Vistoun/EMG-arm/README.md

# EMG-arm
3D vytisknuta roboticka ruka v realné velikosti, poháněna servy. Ovladana pomocí EMG senzorů. 

## Cíl
  **Zkonstuovaní robotické ruky ovládané pomocí EMG (svalových) senzorů.**

## Hardware 
- InMoov robotic arm 
- MyoWare Muscle Sensor
- Arduino UNO R3
- I2C OLED display 128x64
- Rotační enkodér
- 6xMG995R Servo 
- Pololu Micro Maestro 6-CHANNEL
- LiPol 2s 25C battery 
- 5V voltage regulator

### What to do: 
- Složení ruky
- Naprogramování pohybů 
- Naprogramování EMG senzorů 
- Dokumentace 

## Harmonogram

### Červenec 
- ~~Analýza EMG senzorů~~
- ~~Výběr EMG senzorů~~
- ~~Kalibrace EMG senzorů~~ 

### Srpen 
- ~~Výběr modelu ruky~~
- ~~Tisk ruky~~

### Září 
- ~~Složení ruky~~ 

### Říjen 
- ~~Programování ruky~~
- ~~Programování ovládaní pomoci displeje a enkodéru~~ 

### Listopad 
- ~~Programování senzorů~~
- ~~Dokončování pogramovaní~~
- ~~Optimalizace~~
- ~~Přidělání a modelování hardwareové části ruky~~

### Prosinec 
- ~~Dokumentace~~
- ~~Prezentace~~
- ~~Schemata~~
- ~~Posledni dodělávky~~

## Zdroje
 - [Konkureční projekt](https://static1.squarespace.com/static/5fdf30e82dcd53187f20b7f4/t/5fe09c7ef5f64226567c5b9e/1608555676841/Low+Cost+Prosthetic+Arm+Thesis.pdf)
 - [Deníček](https://docs.google.com/document/d/1iRJr1iKNz3n8BKfak4A2ild2_8w_wcecvySByJWGgLg/edit#)
