Vistoun/EMG-arm/docs/lacheta-zaverecne-prace.pdf

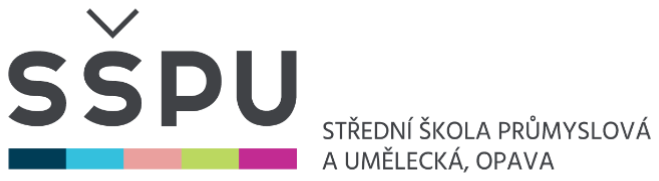
[picture p1: figure]

# ZÁVĚREČNÁ STUDIJNÍ PRÁCE

## dokumentace

# Robotická ruka s využitím EMG

# Václav Lacheta

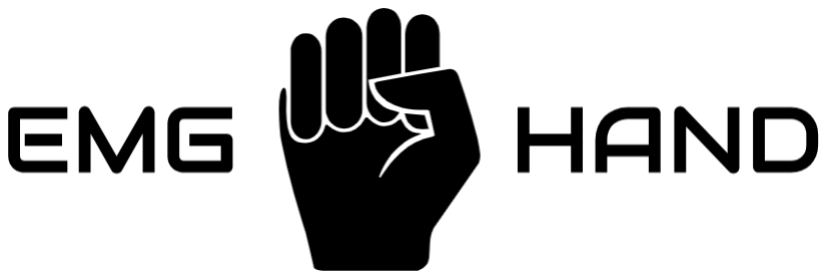
[picture p2: figure]

Obor: | 18-20-M/01 INFORMAČNÍ TECHNOLOGIE se zaměřením na počítačové sítě a programování
Třída: Školní rok: | IT4
| 2021/2022

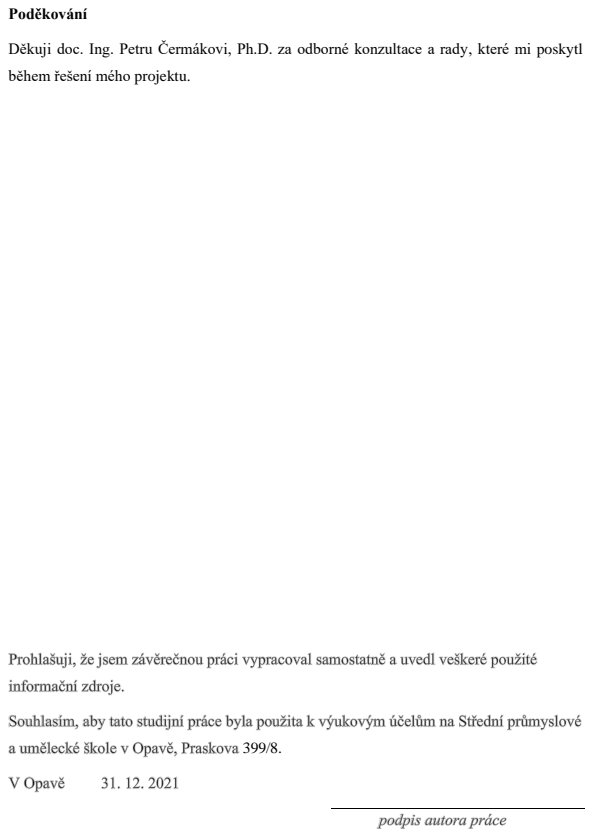
[picture p3: page 2]
Poděkování

Děkuji doc. Ing. Petru Čermákovi, Ph.D. za odborné konzultace a rady, které mi poskytl

během řešení mého projektu.

ANOTACE

Součástí práce bylo sestavení protetické ruky inMoov v životní velikosti ze součástek vy-

tisknutých na 3D tiskárně. Umělá ruka je ovládána pomoci elektromyografických (EMG)

senzorů, díky nimž je možné získávat elektrické svalové signály a převádět je na mechanické

pohyby napodobující chování skutečné lidské ruky. Ruka je upevněna na podstavci obsahu-

jícím nezbytný hardware včetně displeje a rotačního enkoderu, který lze použít k ovládání.

Zařízení je možné ovládat manuálně (natočit každý prst do libovolného úhlu), pomocí EMG

senzorů nebo zvolit některé z naprogramovaných gest.

Klíčová slova

EMG, elektromyografie, InMoov, myoelektrická protéza, rotační enkodér, servomotor, Ar-

duino, 3D tisk, displej

OBSAH

### 3 MOŽNÉ ZPŮSOBY ZPRACOVÁNÍ EMG SIGNÁLU A JEJICH

Závěrečná studijní práce, Václav Lacheta, IT4, 2021/2022

5

ÚVOD

Nad výběrem závěrečné práce jsem přemýšlel dlouhou dobu. Hledal jsem takový projekt,

při jehož řešení bych mohl uplatnit své znalosti programování mikrokontrolerů a využít i

rozmanitou zásobu elektronických součástek, které jsem nashromáždil v průběhu svého stu-

dia na střední škole. Zároveň jsem si přál pustit se také do něčeho nového, co by představo-

valo zajímavou výzvu pro mě samotného a případně bylo přínosné i pro druhé.

Jednoho dne jsem zhlédl video s ukázkou robotické ruky, která se ovládá pomocí EMG sen-

zorů. V tu chvíli jsem se rozhodl, že právě to bude téma mého závěrečného projektu. Navíc

jsem vždy tento typ protézy považoval za něco, co si nemůže normální smrtelník sestavit

doma, takže jsem byl i hodně zvědavý, zda se mi to povede.

Nyní tedy předkládám výsledek své práce, která trvala několik měsíců. Podařilo se mi do-

sáhnout většiny dílčích cílů, které jsem si vytyčil. Z finančních důvodů jsem si bohužel ne-

mohl dovolit pořídit více EMG senzorů a musel jsem si vystačit pouze s jedním, pomocí

kterého dokáži monitorovat sevření nebo otevření pěsti a následně tento pohyb převést na

robotickou ruku.

V praxi se s mým řešením moc nesetkáme, tento způsob se spíše využívá ve světě medicíny

a bioinformatiky pro diagnostiku. Vyspělejší protézy se spíše zaměřují na umístění elektrod

uvnitř svalu, jelikož jsou získávány mnohem přesnější signály.

V úvodní kapitole své dokumentace se zabývám vývojem protéz v historii a popisuji některá

zajímavá technická řešení, která se objevila v minulosti i ta, která se používají dnes. Další

část je zaměřena na problematiku elektromyografie, jež studuje strukturu kosterní svaloviny

a elektrické biosignály, které ze svalů vycházejí. Díky poznatkům tohoto oboru můžeme

využívat EMG senzory a snímat pomocí nich impulzy lidského těla. Nejdůležitější část mé

práce je podrobněji věnována technickému a programovému řešení projektu InMoov ruky.

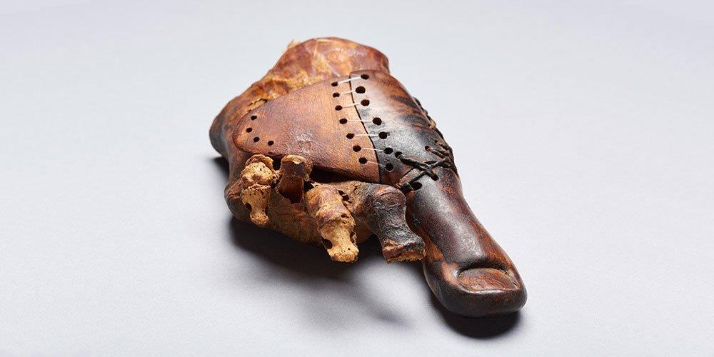
[picture p4: figure]

6

### 1 PROTÉZY

Protézu lze definovat jako „umělé zařízení, které nahrazuje nebo doplňuje chybějící či naru-

šenou část lidského těla“.

V dnešní době existuje mnoho různých typů protéz. Ty se pohybují od kosmetických ozdob

přes jednoduché pasivní mechanické pomůcky, jako jsou různé háky a podobně, až po elek-

tricky poháněné protézy, které mohou alespoň částečně obnovit funkci chybějící končetiny.

### 1.1 Historie protéz

Myšlenka umělého nahrazení ztracených končetin existuje již tisíce let. Existují protézy,

které jsou více než 3000 let staré. Příkladem je takzvaný „káhirský prst“, který byl nalezen

u egyptské mumie a měl nahradit ztracený palec u nohy. Protézy, jako je tato, byly kdysi

vyráběny pomocí přírodních surovin: kůže, dřeva či lnu.

Obrázek 1: Káhirský prst

V roce 300 před naším letopočtem byla Římany vyrobena první známá protetická noha, tak-

zvaná „noha Capua“. Byla vyrobena ze železa a bronzu a měla dřevěné jádro. Během této

doby se objevily protézy, jako jsou ruční háky a kolíkové nohy, které umožnovaly chůzi

nebo držení štítů. Ty byly sestrojeny převážně ze železa a oceli.

7

V době renesance udělala anestezie a léčba ran veliký pokrok, amputace proto byly bez-

pečnější než kdy dříve. S novými možnostmi amputace se začaly šířit vynálezy, jakým byl

například tzv. turniket, které pomohly zastavit těžké krvácení v průběhu amputace. Vznikaly

nové typy protéz - například „železná ruka rytíře Götz von Berlichingen“, s níž bylo možné

pohybovat a manipulovat pomocí pružinového mechanismu uvnitř ruky. V této době se na

protézy používalo především železo, ocel, měď a dřevo.

V období americké občanské války, ale i během světových válek zažila protetika velký po-

sun vpřed vyplývající z vysokého počtu zmrzačených vojáků. Kromě toho byl vyvinut i zcela

nový materiál - pryž, který doplňoval dřívější protézy ze dřeva a kůže.

V letech po druhé světové válce bylo objeveno mnoho dalších materiálů, díky kterým se

dřevo a kůže staly nepotřebnými. Patří mezi ně pryskyřice, polykarbonát, plast a lamináty.

Díky jejich použití se protézy staly lehčí a odolnější.

Materiálové složení se v posledních letech dále zdokonaluje a v současnosti vznikají vysoce

výkonné protézy, které mají vyšší stabilitu, pohodlí a nižší hmotnost. Kromě toho mohou

být součástí protéz senzory umožňující aktivní ovládaní pomocí mikroprocesorů. Vývoj mo-

derních protéz se může opřít i o nové výrobní procesy, jako je 3D tisk, který umožňuje vy-

robit velmi jednoduché i levné protézy.

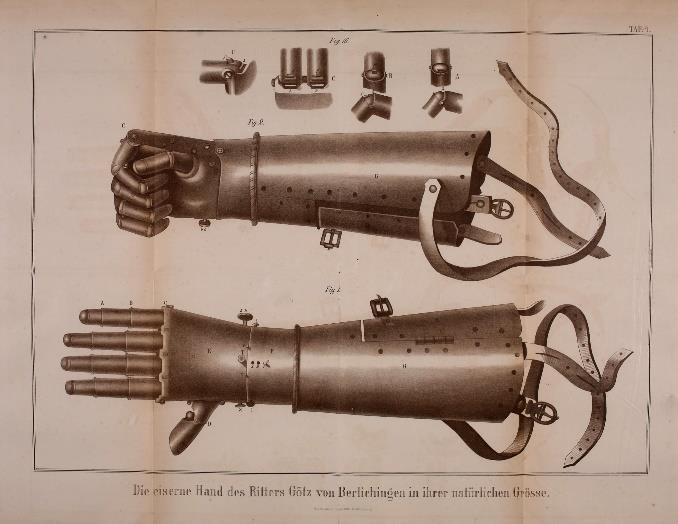
[picture p5: figure]
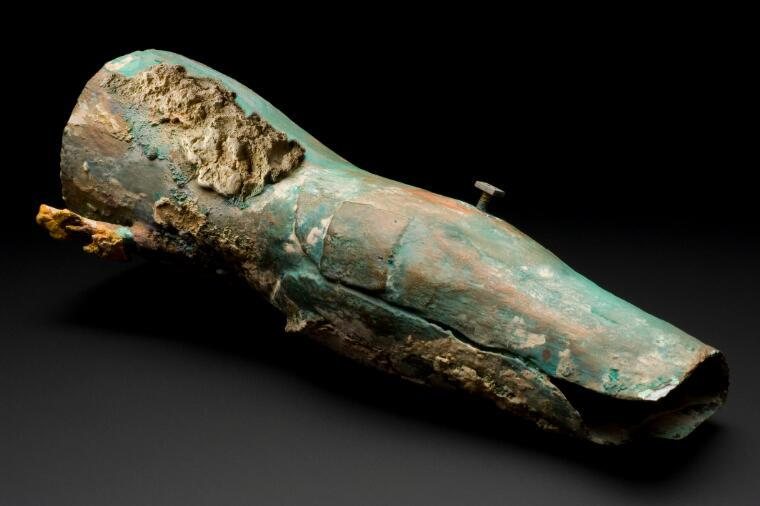
[picture p6: figure]

Obrázek 1.2: Noha Capua | Obrázek 1.3: Ruka Götz von Berlichingen

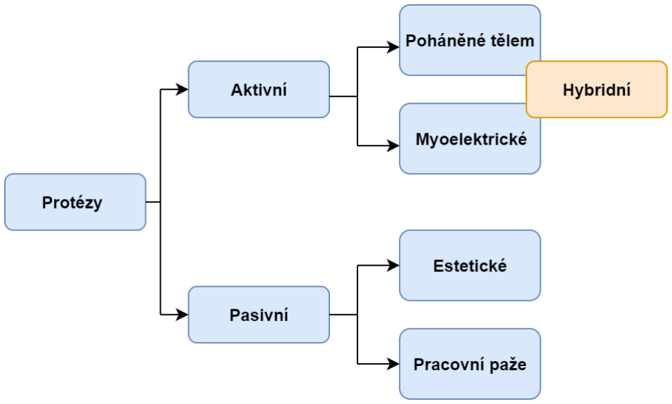
[picture p7: figure]

8

### 1.2 Klasifikace protéz

Protézy můžeme rozdělit na:

1. Pasivní. Protézy, které nemají žádné pohyblivé části. Ty se většinou používají pro

estetické účely. Existují také protézy určené pro speciální úkoly, jako je zahradničení

nebo sport.

2. Aktivní. Ty jsou naopak určeny k podpoře vyšší produktivity a funkčnosti. Mají po-

hyblivé části, které jsou poháněny buď samotným tělem, nebo vnější energií. Navíc

existují ještě hybridní kombinace, které jsou poháněny částečně tělem a částečně

akčními členy

Toto rozdělní je znázorněno na obrázku 1.4.

Obrázek 1.4: Rozdělení protéz

Protézy mohou plnit dva různé úkoly, které se mohou zásadně lišit. Na jednu stranu, protézy

mají obnovit funkce, které byly ztraceny ztrátou končetiny a na druhou stranu se protézy

používají k optické obnově „normálního stavu“ těla. Protézy, které vizuálně připomínají

chybějící končetinu, mají často omezenou funkčnost, zatímco funkční protézy nejsou moc

dobré po vizuální stránce. Proto existuje mnoho pacientů, kteří mají několik různých protéz,

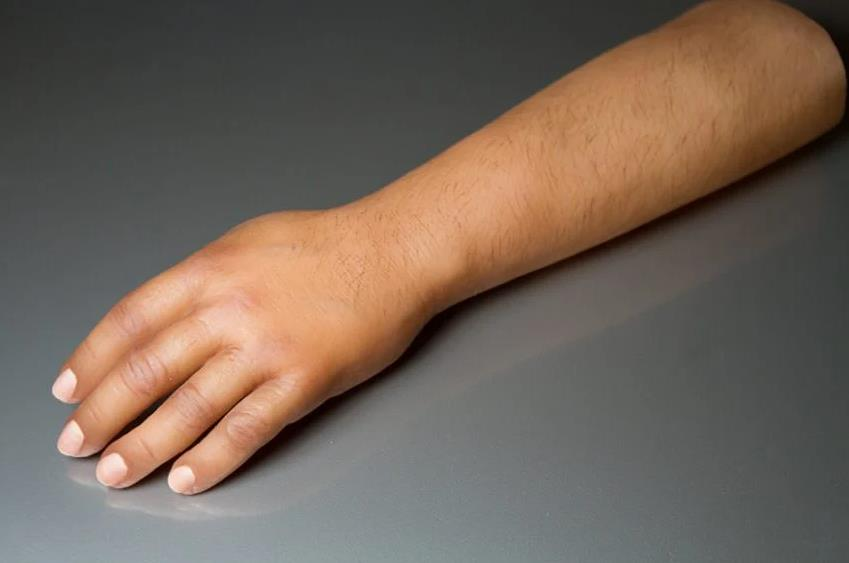
[picture p8: figure]

9

například jednu, která vizuálně připomíná chybějící končetinu, a druhou, která je maximálně

funkční.

### 1.3 Pasivní protézy

Kosmetické použití protéz je velmi důležité, protože zejména horní končetiny jsou často

používané v sociálních interakcích, jako jsou gesta nebo během komunikace. Vizuálně ne-

nápadný vzhled tak může pomoci vyhnout se psychickému stresu z důvodu odlišnosti od

ostatních. To platí zejména v případě, kdy amputací není postiženo pouze předloktí, ale i

paže. Nejlepší reprezentace přirozené ruky poskytují pasivní kosmetické protézy. Lze je při-

způsobit pacientovi pomocí tvaru a barvy; například napodobit barvu kůže a anatomické

rysy, jako jsou znaménka, nebo dokonce ochlupení na pažích. Estetické protézy lze také

použít pro jednoduché manuální úkoly, jako je fixace papíru při psaní. Obecně jsou velmi

lehké a mají vysoký komfort nošení.

### 1.4 Aktivní protézy

Nejčastěji se vyskytují protézy aktivní. Tyto mají pohyblivé částí, které jsou poháněny buď

tělem, nebo vlastním zdrojem energie. S tělesně poháněnými protézami se ovládání provádí

pohybem svalu v blízkosti amputované končetiny. U myoelektrických proté, jsou akční po-

tenciály svalu monitorovány senzory a použity pro pohyb protézy. Aktivní protézy mohou

mít mnoho podob, jako například ruce, pohyblivé háky nebo speciální tvary pro konkrétní

pacienty. Tento druh protéz je obvykle těžší než pasivní, jelikož jsou pro ně určeny větší

Obrázek 1.5: Příklad pasivní protézy

10

zátěže. Díky tomu jsou často vyrobeny z těžších, ale odolnějších materiálů, jako jsou kov nebo tvrzený plast. Úkolem aktivních protéz je obnovit funkčnost postižených končetin, a

zejména ruka má velký význam pro manipulaci s objekty. Pomocí takových protéz je možné

uchopovat předměty a zvládat činnosti v každodenním životě.

### 1.4.1 Protézy poháněné tělem

Protézy poháněné tělem jsou často označovány jako „ovládané kabelem“, protože vyžadují

ocelové kabely během provozu. Obvykle jsou tyto postroje konstruovány tak, že popruh

prochází přes lopatku a připojuje se k tažnému lanku, které ovládá protézu. Protože protézy

poháněné tělem jsou přímo spojeny například s pohybem ramena, mají tak vysokou úroveň

zpětné vazby na základě napětí na ovládacím kabelu. Dalšími výhodami těchto protéz je, že

jsou ve většině případů vodotěsné a snadno se čistí. Jejich jednoduchý design umožnuje po-

stiženým osobám se je rychleji naučit ovládat, a navíc stojí výrazně méně ve srovnání s ak-

tivně řízenými.

Nevýhodou těchto protéz je, že k ovládání potřebují postroj k ovládání. To znamená, že po-

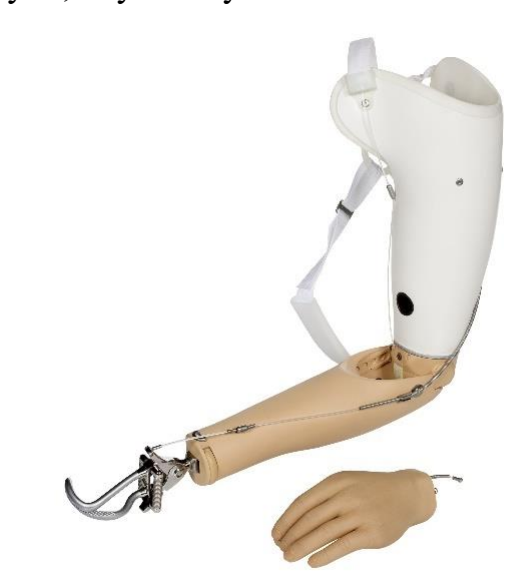
[picture p9: figure]

stižené osoby musí mít určitou sílu a svobodu pohybu, aby mohly takové zařízení ovládat.

Navíc jsou tyto protézy často vizuálně méně při-

tažlivé ve srovnání s elektricky poháněné, a to

kvůli postroji.

Protézy s takovým mechanickým přenosem síly

jsou oblíbenější než ty elektrické. Devadesát pro-

cent lidí, kteří mají aktivní protézu, používají pro-

tézu poháněnou tělem. Jejich největšími klady

jsou nízká hmotnost, odolná konstrukce a lepší

haptická odezva generovaná kabely.

### 1.4.2 Myoelektrické protézy

Tyto protézy jsou převážně elektrické. Mají externí zásobník energie, který napájí vestavěné

akční členy. Obecně se energie ukládá ve formě akumulátoru. Tato zařízení lze ovládat více

vstupy, jako jsou elektromyografické (EMG) signály, zpětná vazba motorů a také vyhrazené

spínače. Takové fyzické spínače jsou zvláště užitečné u vážných amputací. Je to proto, že

Obrázek 1.6: Příklad protézy poháněné

tělem

11

v takových případech obvykle existuje mnoho různých motorů, jsou zapotřebí různé spoje a

je třeba je ovládat samostatně.

Nicméně myoelektrické protézy se ještě častěji používají u méně vážných amputací. Myo-

elektrické protézy jsou založeny na měření elektrického vzruchu ve svalech. Elektrody při-

pojené ke svalům měří elektrické signály z kontrakcí kosterního svalstva. Změny elektro-

magnetických polí, které vznikají při napnutí svalu, zachycuje povrch elektrody a jsou v

podobě napěťových signálů posílány do mikrokontroleru.

Ve většině případů jsou elektrody připevněny ke dvěma svalům, které vykonávají pohyb

v určitém směru, jako je extenzor zápěstí a flexor zápěstí. Pro tento účel se používá jeden

sval pro jeden směr pohybu protézy. Například napnutím jednoho svalu se otevře dlaň a

napnutí protikusu se dlaň uzavře. Aby se zabránilo nedobrovolným pohybům, jsou pro sig-

nály EMG nastaveny prahové hodnoty. Teprve po překročení určitého prahu se protéza za-

čne pohybovat.

Jednou z výhod takové myoelektrické protézy je, že umožňuje větší uchopovací síly ve srov-

nání s protézami poháněnými tělem. V některých případech to může být výhodné při držení

objektů na delší dobu. Kromě toho nejsou pro účely ovládání potřeba žádné postroje. To

dovoluje ovládání více os a kloubů současně. Absence postroje také umožňuje, aby vypadaly

více jako skutečné končetiny.

Existují však také důvody, proč jsou protézy poháněné tělem 10krát populárnější než myo-

elektrické. Je to dáno především vyšší pořizovací cenou takových zařízení. Navíc jsou méně

robustní a kvůli vestavěné elektronice jen částečně vodotěsné. Protože mezi nimi není žádné

mechanické spojení zbývající končetiny s protézou, je haptická zpětná vazba horší. Někdy

je pro postižené těžší, aby správně vyhodnotili a použili požadovanou uchopovací sílu.

Kromě toho se tyto protézy kvůli složité konstrukci snadněji lámou a musí být častěji servi-

sovány.

Elektrody jsou jejich další nevýhodou, neboť se může stát, že se pohnou nebo ztratí kontakt.

V těchto případech nelze protézy správně provozovat. Konstantní kontakt s elektrodami

může také způsobit podráždění kůže nebo nepříjemný pocit, pokud protéza není správně

upravená. Přesto se tyto protézy neustále vyvíjejí a mohly by být v budoucnu více rozšířené.

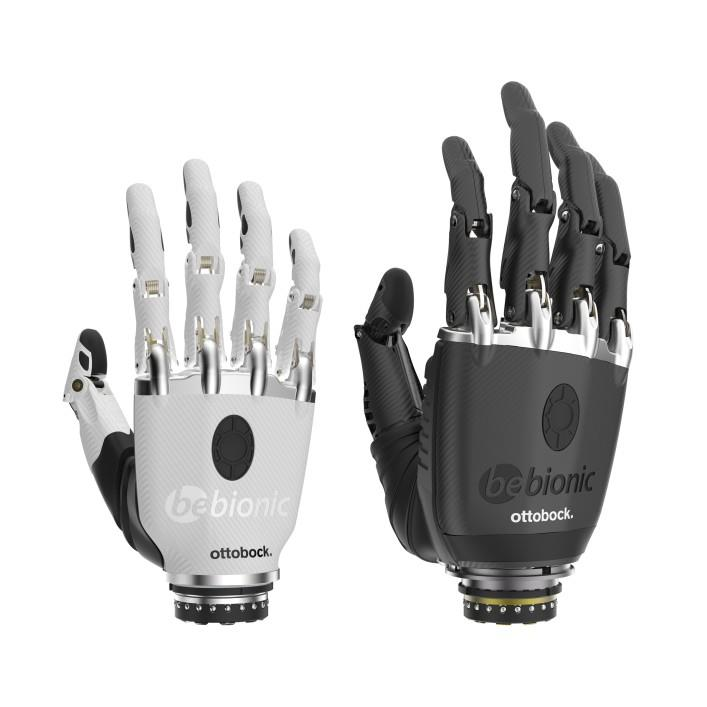
[picture p10: figure]

12

1.4.3Hybridní protézy

Existují i protézy, které se skládají z kombinace tělesně poháněných a myoelektrických. Tato

kombinace umožňuje využít výhody obou typů, například mohou dosáhnout vysokých ucho-

povacích sil při zachování nízké hmotnosti protézy. Navíc tento přístup může usnadnit ovlá-

dání protézy.

Obrázek 1.7: Myoelektrická protéza

13

### 2 ELEKTROMYOGRAFIE

### 2.1 Svaly horní končetiny

Kosterní svaly jsou součástí svalstva odpovědné za aktivní pohyby těla, a tedy i součástí

jednoho ze tří hlavních typů svalů. Stejně jako srdeční svaly patří kosterní svaly do skupiny

příčně pruhovaných svalů a označují se také jako dobrovolné svaly. Až na pár výjimek, jsou tyto svaly napojeny na kost šlachami. Často existují v párech, přičemž první sval je primár-

ním hybatelem a druhy je jeho antagonistou. Například, biceps a triceps jsou taková dvojice

antagonistů. Když se jeden z nich stáhne, druhý se uvolní a umožní pohyb a naopak.

Kosterní svaly mají složitou strukturu. Skládají se z fasciklů, které jsou svazky prodlouže-

ných svalových vláken. Samotná svalová vlákna se skládají ze svazků myofibril. Samotné

myofibrily jsou tvořeny z myozinových a aktinových vláken. Tato dvě vlákna jsou nasklá-

daná v pravidelně se opakujících sestavách a jsou zodpovědná za samotnou kontrakci svalů

klouzáním proti sobě navzájem. Tato myozinová pole se nazývají sarkomery. Motorické

neurony, které řídí kontrakci, jsou spojeny ve snopci svalových vláken a společně se nazývají

motorická jednotka.

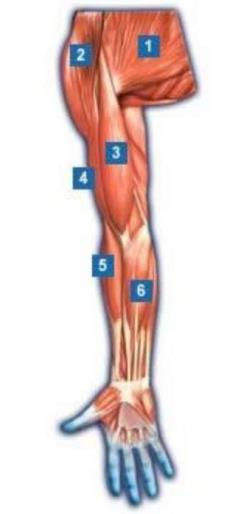
[picture p11: figure]

Nejdůležitější svaly jsou:

1. Musculus pectoralis major (velký sval prsní)
2. Musculus deltoideus (deltový sval)
3. Musculus bizeps brachii (dvojhlavý sval pažní)
4. Musculus trizeps brachii (trojhlavý sval pažní)
5. Musculus brachioradialis (sval vřetenní)
6. Musculus flexor digiti (sval který zajištuje ohýbaní prstů)

Motorické neurony se nacházejí uvnitř mozkového kmene a míchy a jsou spojeny se svalem

přes axony, který mohou přenášet excitační signál na velké vzdálenosti. Aktivace svalových

vláken se děje elektrickými potenciály buněčných membrán. Díky otevíráním a zavíráním

Obrázek 2.1: Svaly horní

končetiny

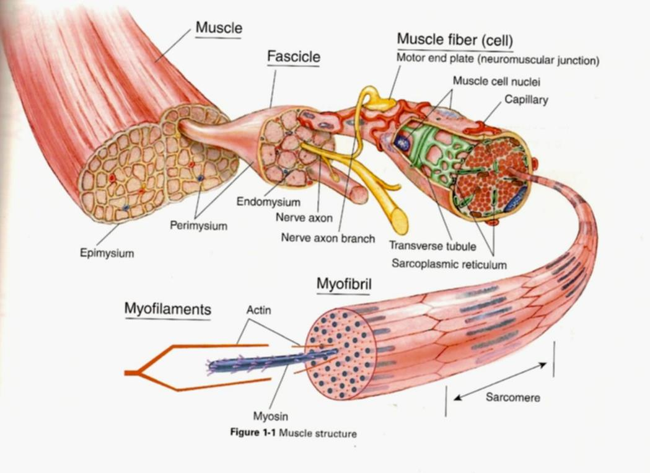
[picture p12: figure]

14

iontových kanálů umožnují membrány pohyb iontů a vytvořit tak signál elektromagnetic-

kého pole. Tento signál cestuje podél axonů jako vlna a skončí v motorickém neuronu.

Místo, kde se motorické neurony spojují se svalovými vlákny, se nazývá neuromuskulární

spojení. To je místo, kde vlákna začnou reagovat na signál motorického neuronu a tím za-

čnou kontrakce.

### 2.2 EMG signály

Akční potenciály se vytvářejí během kontrakce kosterní svaloviny. Tyto akční potenciály se

dají měřit a jsou také základem EMG signálů. EMG signály jsou používané pro analýzu a

klinickou diagnostiku v biomedicínských aplikacích, jako jsou rehabilitace pohybových vad.

Elektrické proudy generované během procesu flexe lze měřit pomocí elektrod na svalu nebo

uvnitř svalu. EMG signály jsou poměrně komplikované, protože jsou závislé na anatomii

fyziologické vlastnosti svalu. Nečistoty těchto signálů jsou zcela běžné a hromadí se při ces-

tování tělem. Signál EMG je také sumou několika motorických jednotek, které vysílají ve

stejnou dobu, a tak může docházet k interakcím mezi těmito různými signály.

Intervaly, ve kterých se vyskytují akční potenciály konkrétní motorické jednotky, jsou ná-

hodné.

Obrázek 2.2: Struktura kosterního svalu

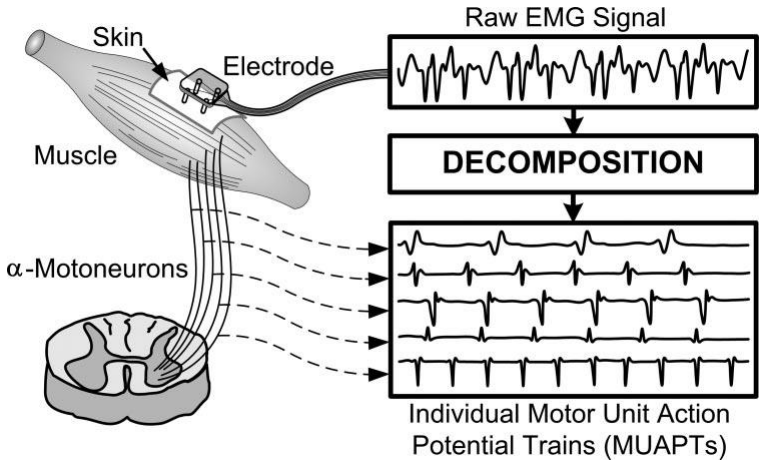
[picture p13: figure]

15

Samotný akční potenciál motorické jednotky je kombinací akčních potenciálů svalových

vláken patřící k jedné motorické jednotce. Lze to popsat vzorcem níže.

x(n) = ∑ ℎ(r)e(n − r) + w(n)

N−1

r=0

V tomto vzorci je x(n) výsledný EMG signál, e(n) impuls odpalu n, h(r) akční potenciál

motorické jednotky, w(n) aditivní bílý Gaussův šum a N počet střel motorických jednotek.

### 2.3 Snímání EMG signálů

EMG signály jsou snímány elektrodami, které jsou buď umístěny na kůži nad svalem, nebo

uvnitř svalu. Obě varianty mají svá pro a proti. Při použití intramuskulárních senzorů musí

být prostředí a senzory sterilizovány, protože se jedná o invazivní postup, který nese velké

riziko přenosu nemoci nebo spuštění infekce. Na druhou stranu, jakmile je elektroda umís-

těna, tak nezpůsobuje žádné nepohodlí a signály nejsou zkresleny tkáněmi svalů a kůže.

Tento proces vede k větší čistosti signálu nad šumem. Na druhou stranu, povrchové elek-

trody mohou být kdykoliv přemístěny, pokud poloha není vhodná a nepotřebuje k tomu

žádné invazivní postupy. Většinou se povrchové elektrody využívají pro krátká měření. Je

velmi důležité elektrody správně umístit a používat elektrody pro konkrétní úkol, výběr

Obrázek 2.3: Dekompozice EMG signálu

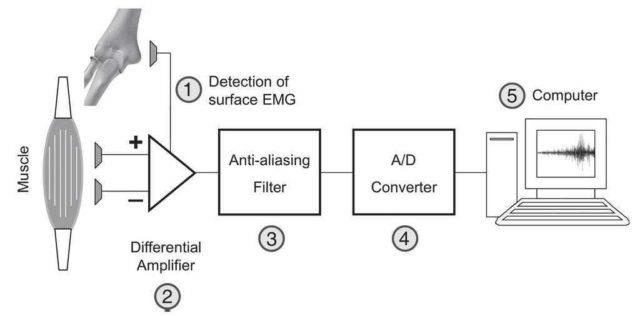
[picture p14: figure]

16

místa totiž velice ovlivní získaný signál. Chceme-li získat nejvyšší sílu signálu, tak elektrody

musí být umístěny uprostřed svalu ve směru svalových vláken. Nejčastější používané elek-

trody jsou Ag/AgCL, protože nejsou polarizovatelné a umožnují proudový tok kůže. Ve vět-

šině případů jsou připevněny pomocí vodivého gelu pro snížení impedanci kůže.

Obvykle se používají 2n + 1 elektrody. Dvě pro každý kanál n a jedna referenční (uzemňo-

vací) elektroda, která je umístěna na elektricky nesouvisející tkání.

Poté, co je signál zachycen, je obvykle zesílen, protože jeho amplituda je poměrně malá. Pro

první etapu zesílení se běžně používá diferenciální zesilovač. Diferenciální zesilovač se po-

užívá k eliminaci společných proudů. Signál je snímán na třech místech, dvě detekční elek-

trody a jedna referenční, která definuje neutrální zem, kterou sdílejí další dvě elektrody. Ja-

kýkoliv společný signál pro tyto dvě elektrody bude odstraněn, naopak signály, které nesdí-

lejí, budou poté zesíleny.

Poté se použije zesilovač k dalšímu zvýšení amplitudy signálu. Pro eliminaci vysokého šumu

se používá plášť nízko propustného filtru frekvence. Dále lze použít usměrnění signálu pro

překlopení částí negativního signálu na pozitivní. Nakonec je použit A/D převodník, aby

počítač nebo mikrokontroler mohl pracovat se signálem EMG.

Obrázek 2.4: Schéma nahrávaní EMG

17

### 3 MOŽNÉ ZPŮSOBY ZPRACOVÁNÍ EMG SIGNÁLU A JEJICH

IMPELEMTACE V PROTÉZÁCH

### 3.1 Mikrokontrolery

Je na výběr několik možností. První možností je použít mikrokontroler k měření svalové

aktivity a vyhodnocování signálu. Například Arduino Uno je založeno na čipu ATMEL

ATmega328, pracuje na frekvenci 16 MHz a může komunikovat s ostatními zařízeními přes

UART, SPI a I2C. Kromě toho vstupní a výstupní (GPIO) piny lze použít k ovládání různých

dalších periferií nebo ke čtení analogových a digitálních signálů díky vestavěnému 10bito-

vému A/D převodníku. Další výhodou těchto vývojových desek je, že je lze jednoduše pro-

gramovat a nevyžadují vyhrazené přístupy a bitové manipulace jednotlivých registrů, navíc

jsou takové desky dost rozšířené, snadno dostupné a existuje velké množství už vytvořených

kódů a dokumentací pro další usnadnění programování. Nevýhodou však bývá výkon pou-

žitých procesorů, protože musí být co nejmenší a energeticky efektivní, mají často jen ome-

zený výkon. To znamená, že na těchto zařízeních lze provádět pouze jednoduché matema-

tické operace, a to může mít významný dopad na výkon celého systému, zejména pro apli-

kace v reálném čase, jako je EMG analýza. Kvůli nízkému výkonu nemusí být signály na-

čteny včas a zpracování může trvat déle, což má za následek velké zpoždění v celém systému

nebo omezenou funkčnost, proto je lepší se dívat po dalších výkonnějších mikrokontrole-

rech.

### 3.2 Senzory

Prvním krokem při získávání dat je identifikace správných pozic pro elektrody. Aby bylo

možné správně rozeznávat pohyby jednotlivých prstů, je potřeba použít několik svalových

signálů. Na monitorování každého prstu je potřeba minimálně 4 senzory čili 4 kanály. Jeden

pro palec, jeden pro prostředníček, jeden pro ukazováček a jeden senzor pro prsteníček a

malíček dohromady. Nejlépe je použít 5 senzorů, aby měl každý prst vyhrazený kanál.

Celkem máme tedy 11 elektrod. Pět párů po dvou elektrodách a další referenční elektrodu.

Tato referenční elektroda je umístěna na zadní straně předloktí v úrovni loktu, protože tam

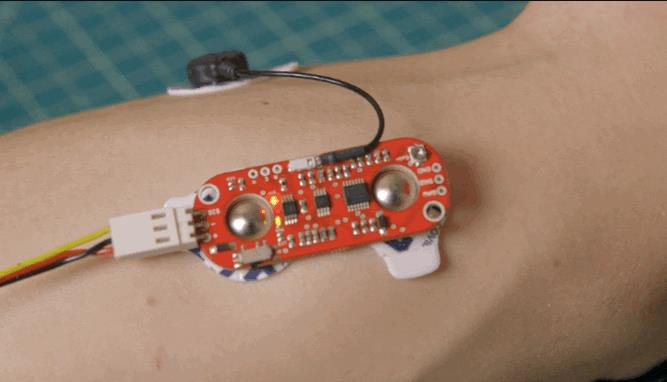
[picture p15: figure]
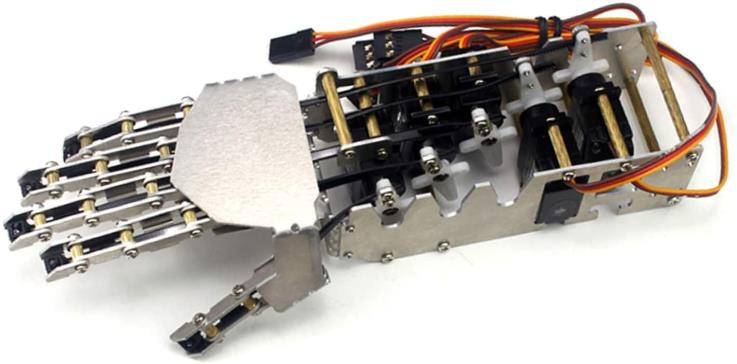
[picture p16: figure]

18

se dá očekávat malá svalová aktivita, nebo na kosterní části ruky. Senzory jsou poté připo-

jeny k samotným elektrodám, aby zesílily a přenesly signál do mikrokontroleru.

V dnešní době jsou EMG senzory poměrně dost rozšířené a máme na výběr hned několik

různých senzorů od různých firem. Ve své práci jsem použil senzory MyoWare od Advancer

Technologies. Tyto senzory lze provozovat pro napětí 3,3 V nebo 5 V. Logika zpracování

svalového signálu je řešena přímo na senzorech, tudíž z nich můžeme číst obálku signálu.

Pokud je pro tuto funkci nechceme použit, můžeme zachytit i surový EMG signál a zpraco-

vání si řešit potom sami. Zesílení signálu lze nastavit pomocí potenciometru. Výstupní ana-

logový signál už potom čteme a zpracováváme na mikrokontroleru.

### 3.3 Příklady protéz

3.3.1Inteligentní humanoidní robotická ruka Sain

Tato robotická ruka se dá velmi snadno používat, protože už je předem složená.

Obrázek 3.1: Myoware muscle sensor

Obrázek 3.2: Sain Smart 5-DOF

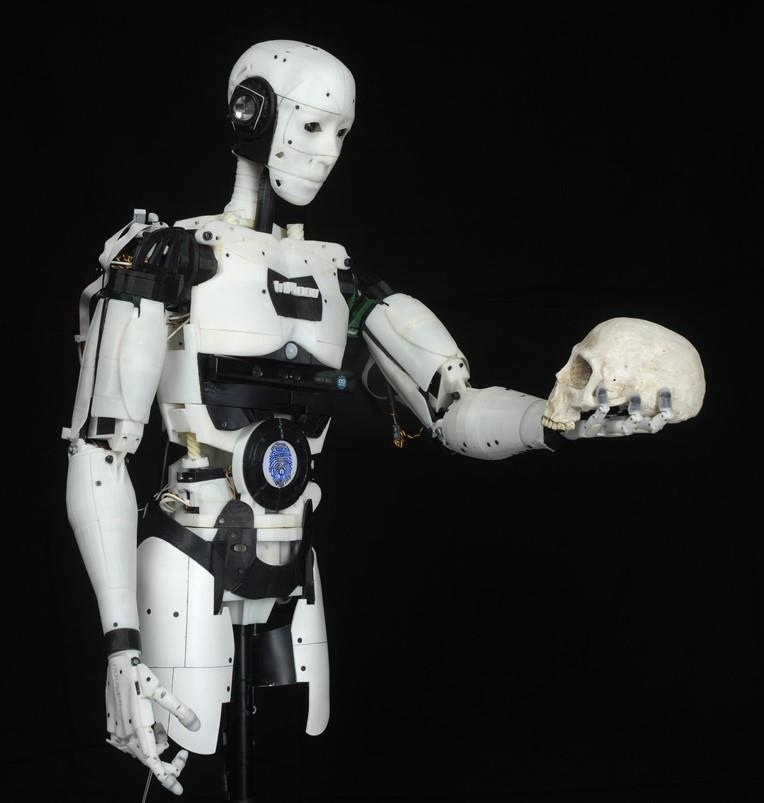
[picture p17: figure]

19

3.3.2Protetická ruka InMoov

Protetická ruka InMoov nabízí lepší způsob zobrazení pohybů. Je součástí projektu s otevře-

ným zdrojovým kódem, který založil francouzský sochař a designér Gael Langevin. Projekt

InMoov se skládá ze stovek 3D tisknutých dílů, které lze připojit k pohonům a vytvořit tak

robota v životní velikosti. Jednotlivé končetiny lze ovládat a rozpohybovat pomocí motorů.

Stejně jako u ruky Sain Smart lze prsty ovládat jednotlivě. To se také provádí pomocí 5 serv,

které se montují do předloktí a ovládají prst přes provázky. Jedno servo může být použito

k otáčení ruky kolem zápěstí. Ve srovnání s rukou Sain Smart používají InMoov větší a

mnohem silnější serva. Kromě toho návrh prošel několika designovými iteracemi a neustále

se přizpůsobuje a zlepšuje.

Obrázek 3.3: Robot InMoov

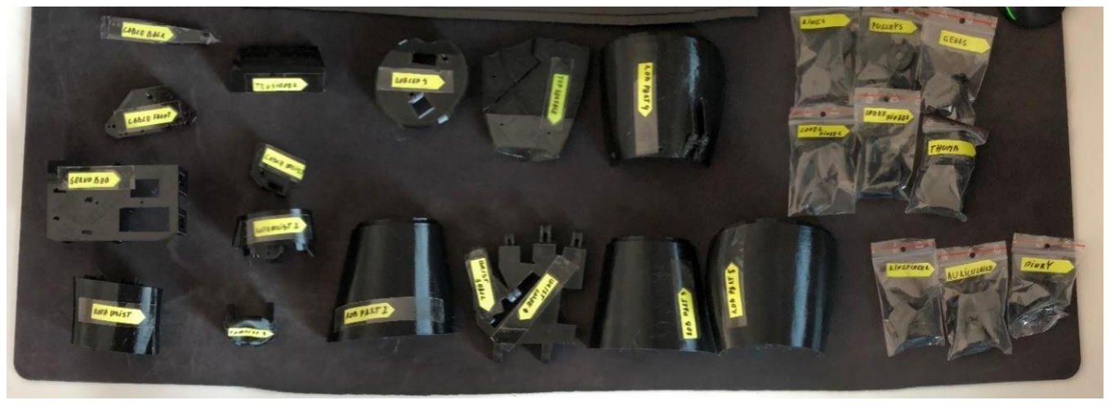
[picture p18: figure]

20

### 4 SESTROJENÍ RUKY

Kompletní sestrojení ruky se rozdělovalo na více částí.

- Sestrojení mechanické časti ruky.
- Ovládaní servo pohonů na ruce.
- Ovládání pomocí EMG senzorů.
- Ovládaní přes uživatelské rozhraní.
- Sestrojení podstavce pro zlepšení vzhledu a manipulace.

### 4.1 InMoov ruka

Pro svůj projekt jsem zvolil sestrojení protetické ruky InMoov. Na InMoov webu jsou do-

stupné všechny díly a také podrobný návod jak ruku složit. Celá ruka se skládá z 50 různých

dílů. Díly jsou vytisknuté z PETG materiálu. Většinou se díly lepily k sobě, ale některé jsou

i našroubované.

Ve spodní části ruky je přimontovaných pět MG995 servo po-

honů, které pohubují s prsty.

Obrázek 4.1: Díly k ruce

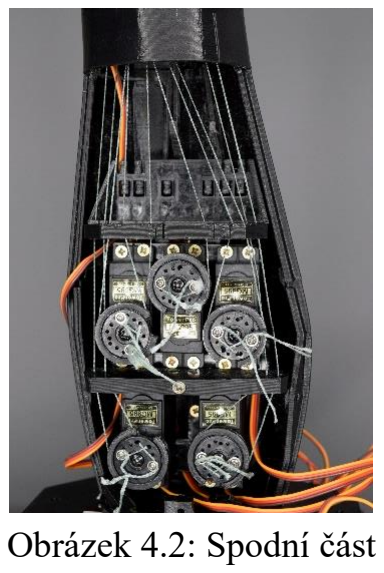
[picture p19: figure]
Obrázek 4.2: Spodní část

ruky

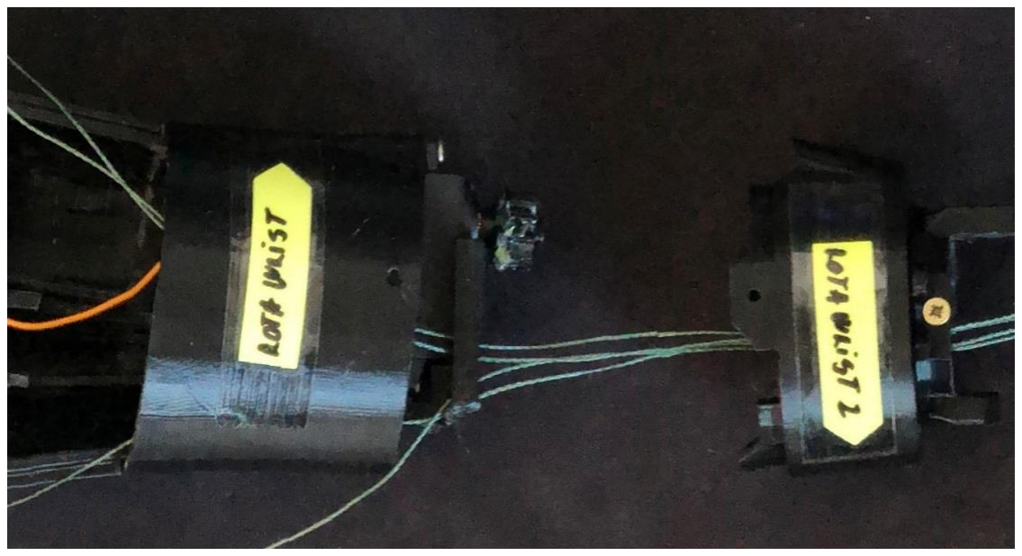
[picture p20: figure]
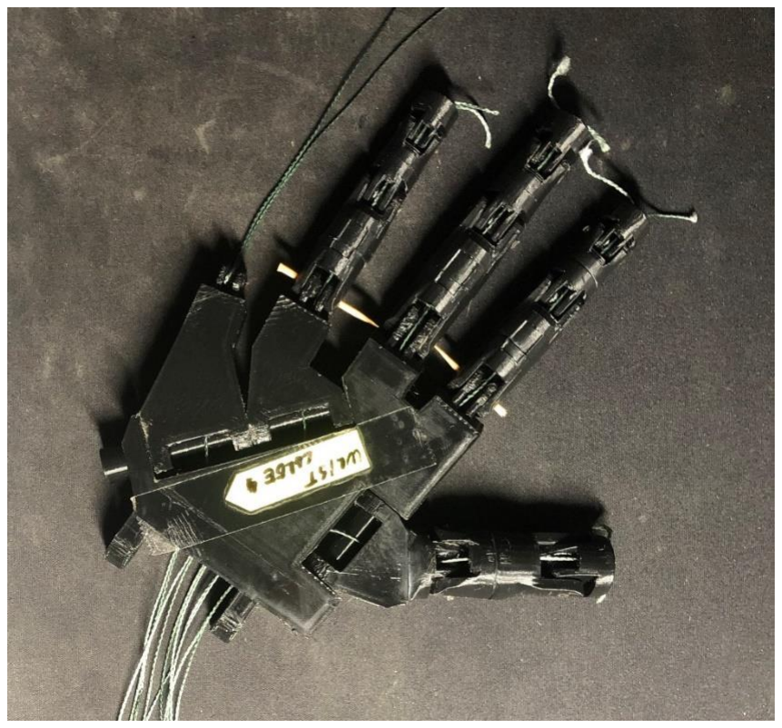
[picture p21: figure]

21

Další MG995 servo je přimontované v zápěstí pro otáčení dlaně.

Články prstů jsou k sobě lepené a pro klouby je využita válcovitá tyč o průměru 3 mm, která

slouží jako čep. Články prstu jsou přes pomocné vodicí díry propleteny vždy dva stejně

dlouhé rybářské pletence.

Obrázek 4.3: Servo na otáčení dlaně

Obrázek 4.4: Dlaň

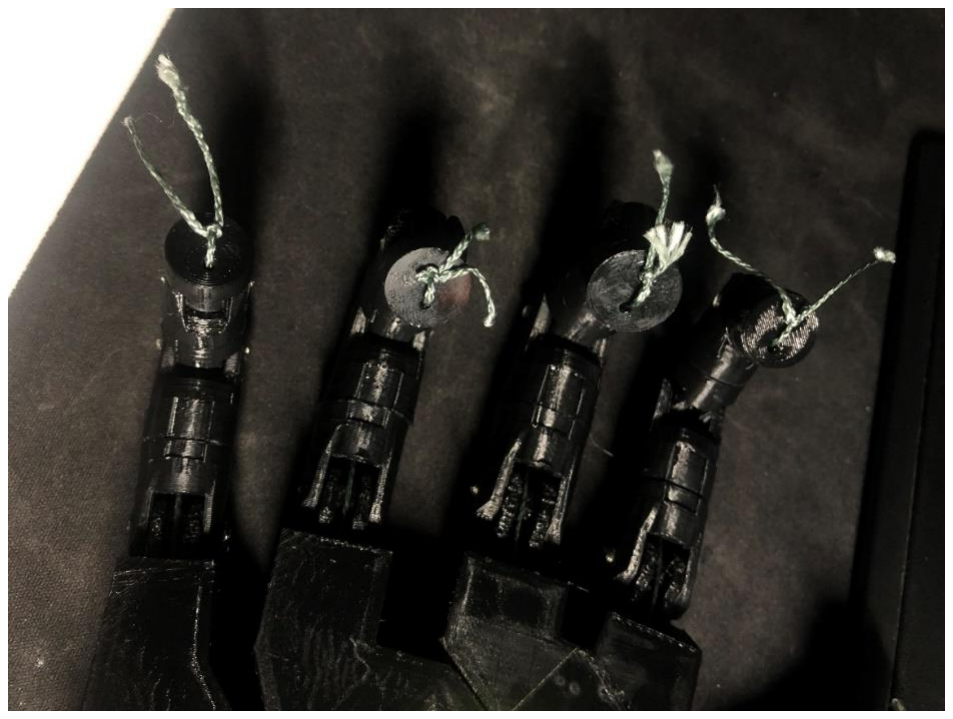
[picture p22: figure]
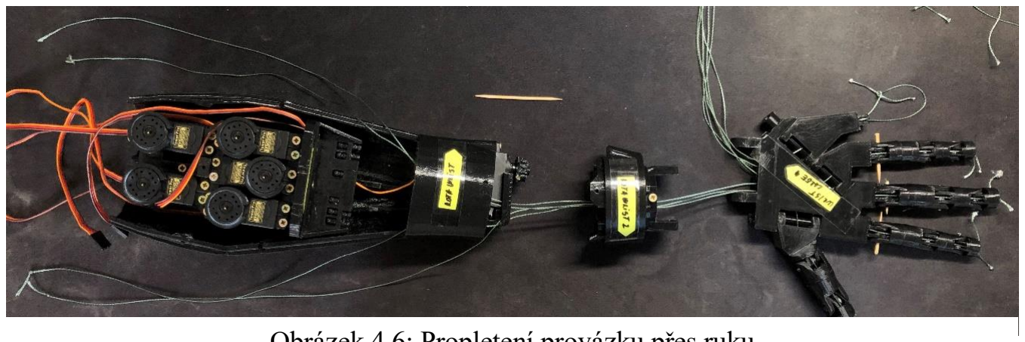
[picture p23: figure]

22

Na konečcích prstů jsou dva provázky svázané k sobě, aby utvořily jeden.

Dále jsou provázky propletené přes dlaň až po zápěstí a tam jsou navázané na serva, které je

napínají a tím napodobují funkci šlachy: když servo zatáhne za jeden konec provázku, prst

se ohne a když zatáhne za druhý, tak se prst znova otevře.

Obrázek 4.5: Konečky prstů

Obrázek 4.6: Propletení provázku přes ruku

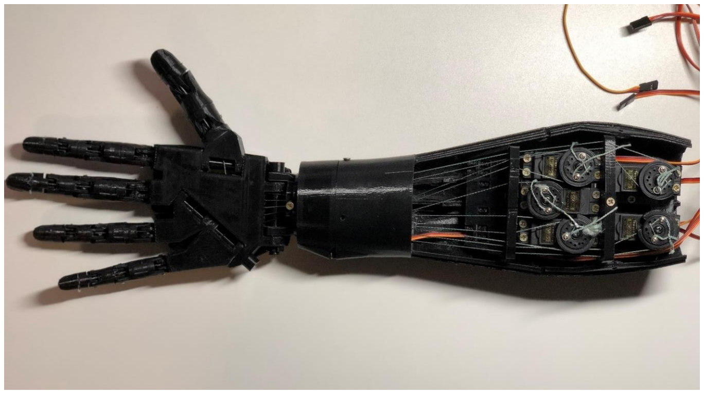
[picture p24: figure]

23

Provázky jsou namotané na kroužky servo motorů a pomoci dvou šroubků se provázek na-

pne. Všechna serva ovládá Micro Maestro 6-Channel od Pololu, který komunikuje s Ardui-

nem přes protokol UART.

### 4.2 Ovládaní servo motorů

Micro Maestro, které ovládá servo pohony a Arduino spolu komunikují pomocí protokolu

UART čili přes RX a TX piny na desce. Protože Arduino UNO má dva vyhrazené RX a TX

piny, které jsou potřeba pro nahrávání kódu, tak si je simuluji na jiných pinech pomocí kni-

hovny SoftwareSerial.h

Díky knihovně pro Micro Maestro už šlo samotné programování pohybu serv jednoduše. Pro

zefektivnění a pro lepší přehlednost kódu jsem vytvořil třidu Arm, která obsahuje veškeré

potřebné metody k ovládaní serv, jako jsou openIndex(), closeIndex(), getIndexPos() a další.

void Arm::openPinky()const{
maestro.setTarget(this->pinky,this->open);
return;
}

void Arm::closeThumb()const{ maestro.setTarget(this->thumb, close); return;
}

Obrázek 4.7: Sestavená ruka

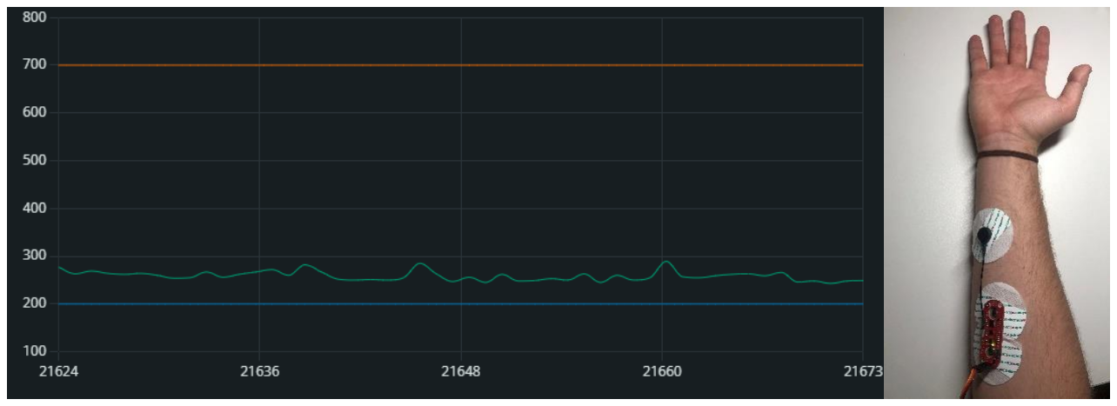
[picture p25: figure]
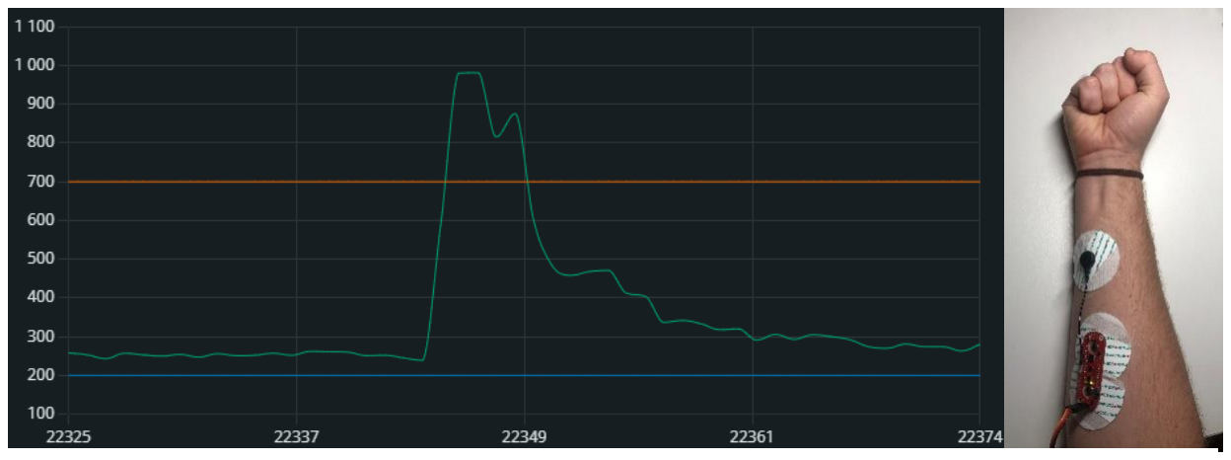
[picture p26: figure]
Obrázek 4.9: Graf EMG hodnot

24

### 4.3 Ovládaní ruky pomocí EMG

Mým cílem bylo monitorovat každý prst, ale v průběhu jsem zjistil, že tento cíl je dosti vzdá-

lený z důvodu nedostatku financí. Cena těchto senzorů je poměrně dost vysoká.

Rozhodl jsem se proto pro jednodušší řešení pouze s jedním senzorem a monitorování otevření a sevření pěsti. Část kódu, která se stará o ovládání ruky pomoci EMG senzorů, je

poměrně dost jednoduchá. Když si necháme vypisovat hodnoty ze senzorů na graf, tak do-

staneme takovýto výsledek.

Z grafu jde vidět, že když zatneme pěst, tak hodnota rapidně vzroste, protože v tu chvíli

projde přes senzor elektrický proud. Poté jsou hodnoty zase nízké, i když držíme zatnutou

pěst. Hodnota opět vzroste, když pěst uvolníme.

Čili když hodnota bude větší než naše nastavená prahová hodnota, tak se pohne servy tak,

aby utvořily pěst.

Obrázek 4.8: Graf EMG hodnot

25

Problémem je, že nevíme, kdy má uživatel sevřenou pěst a kdy ne, protože nárůsty hodnot jsou téměř stejné v obou případech. Čili pro moje řešení jsem použil jednoduchý přepínač,

který přepíná mezi stavy pěst a dlaň. Nárůst hodnoty trvá nějakou chvílí, takže ještě před

přepnutím stavu se počká 250 ms, než k němu dojde.

void sensor() {
// Read the values from EMG sensor sensorValue = analogRead(A0); unsigned long currentMillis = millis();

// Swap for fist flag
if (sensorValue >= sensorTreshold && sensorFist == 0) { // Wait some time to prevent unwanted switching
if (currentMillis - prevMillis > sensInterval) { sensorFist = 1;
prevMillis = currentMillis;
}
} else if (sensorValue >= sensorTreshold && sensorFist == 1) { if (currentMillis - prevMillis > sensInterval) { sensorFist = 0;
prevMillis = currentMillis;
}
}
}

### 4.4 Displej a uživatelské ovládaní

Ruka má k dispozici i uživatelské ovládání, kdy si na displeji může pomocí rotačního en-

kodéru uživatel vybrat mezi různými módy ovládání:

1. Manuální – v tomto modu si může uživatel natočit jednotlivý prst do určitého úhlu

ručně.

2. EMG – zde se bude ruka ovládat pomocí EMG senzorů. Uživatel zde může vidět i

aktuální hodnotu senzoru a také si upravit hraniční hodnotu, při které má ruka sevřít

pěst.

3. Gesta – zde si může uživatel vybrat mezi různými před-programovanými gesty.

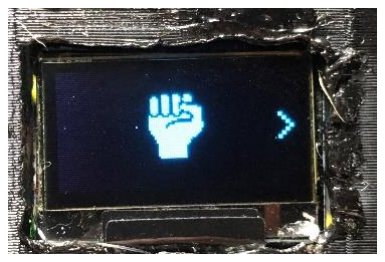
[picture p27: figure]

26

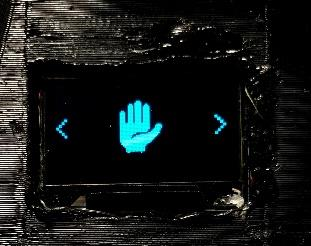
[picture p28: figure]
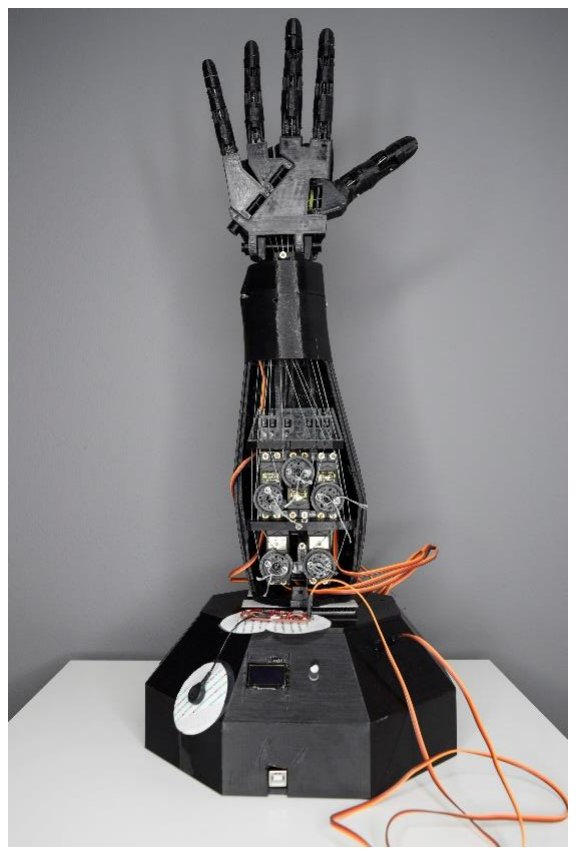
[picture p29: figure]

### 4.5 Podstavec

Myšlenka podstavce se zrodila hlavně proto, aby

došlo k zapouzdření hardwaru, ale také z důvodu

efektnější prezentace funkčnosti celého zařízení.

Ruka drží na podstavci pomocí kvalitního suchého

zipu, ze kterého se ruka v případě potřeby jedno-

duše uvolní. Na boční straně podstavce jsou konek-

tory, které slouží pro jednoduché a rychlé připojení

servomotorů k celému systému. Kromě konektoru

pro serva je dostupný rovněž konektor pro připojení

EMG senzorů.

### 4.6 Využité součástky

- Arduino UNO R3
- InMoov ruka
- Pololu Micro Maestro 6-channel
- 6xMG995 servo
- Myoware muscle sensor Advancer Technologies
- Ag/AgCL elektrody
- Rotační enkodér
- 0.96" OLED displej 128x64 I2C
- Pasivní bzučák
- Li-pol 2250mAh 7.4V 25C
- 2x10 kΩ rezistor

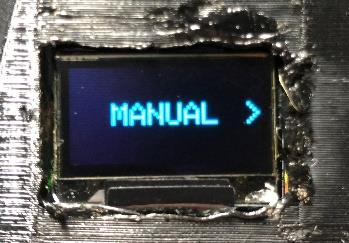
[picture p30: figure]

Obrázek 4.11: Ukázka uživatelského ovládaní

Obrázek 4.9: Hotová ruka na pod-

stavci

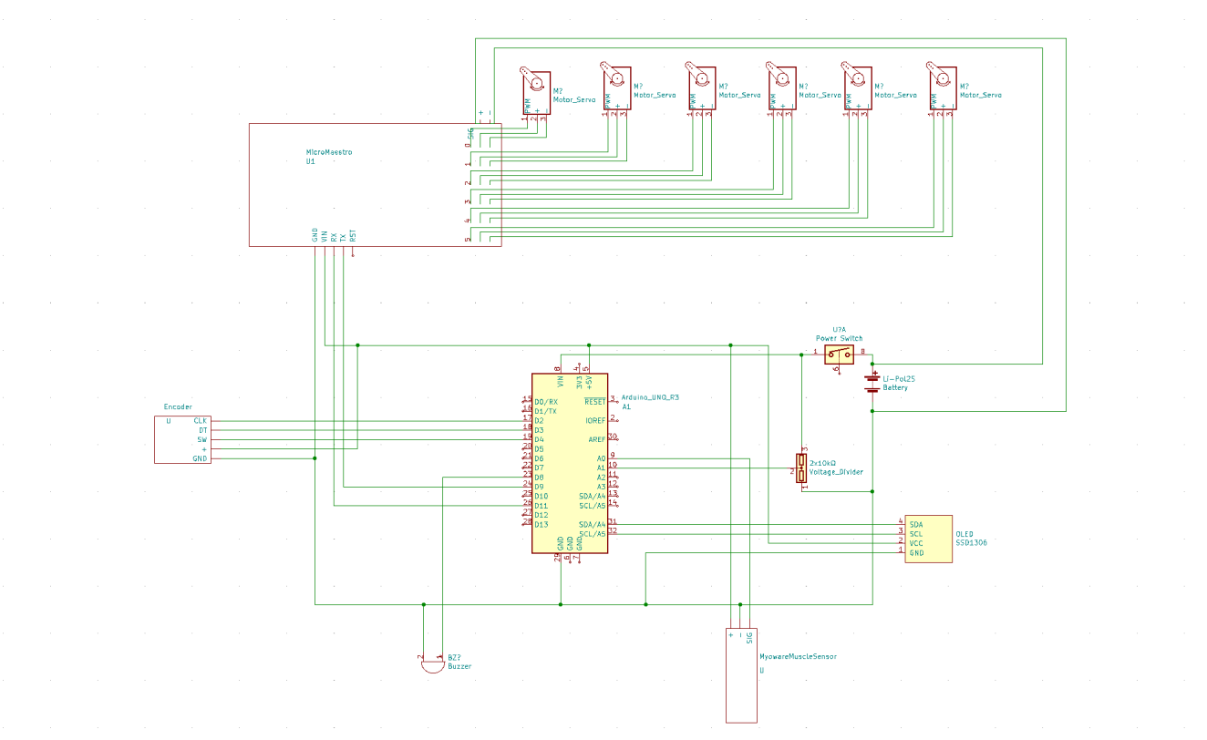
[picture p31: figure]

27

- Napěťový regulátor na 5V
- Přepínač

Obrázek 4.10: Schéma zapojení

28

ZÁVĚR

Jak už jsem zmínil v úvodu, tak moje práce splnila většinu mých dílčích cílů, jako třeba bylo

sestavení robotické ruky InMoov. Aby byl projekt o něco více zajímavější, tak se mi povedlo

přidat uživatelské rozhraní, které umožňuje 3 způsoby ovládaní.

Z důvodu nedostatků financi, jsem si nemohl dovolit koupit více EMG senzorů, které by mi

umožnily monitorovaní všech prstů. V mojí práci jsem si teda musel vystačit pouze s jedním,

ale i tak jsem s výsledkem sledovaní sevření a otevření pěsti velice spokojen.

V průběhu jsem narazil na řadu problémů, díky kterým jsem si rozšířil znalosti v elektro-

technice a programovaní mikrokontroleru. Největší problém byl výkon mikrokontroleru.

Vzhledem k tomu, že už jde takřka o real-time aplikaci, poohlížel jsem se i po nějakých

procesorech s architekturou ARM. Nejlepším adeptem byl Arduino DUE, ale jeho nevýho-

dou byla vysoká cena. Nakonec jsem se rozhodl sáhnout po absolutním výkonnostním mi-

nimu, koupit Arduino UNO, a to hlavně díky jeho nízké ceně a vyšší vzorkovací frekvenci

na A/D převodníku, která činí 9600 Hz a doporučuje se při použití s EMG senzory. Bohužel

i tak ho ženu na úplný okraj výkonnosti; musel jsem proto přizpůsobit kód, abych ušetřil co

nejvíce paměti RAM.

Projekt má stále mnoho prostoru pro různá vylepšení, jak už u mechanické ruky samotné,

jako třeba zlepšit napnutí provázků, aby byli pohyby prstů co nejlepší nebo vylepšit kód pro

ovládaní ruky s EMG a taky samotné snímaní EMG, nebo taky vylepšit podstavec a uživa-

telské rozhraní.

Do budoucna bych se možná chtěl k tomuto projektu a docílit snímaní všech jednotlivých

prstů a aby celý program běžel na ARM procesoru.

29

SEZNAM POUŽITÝCH INFORMAČNÍCH ZDROJŮ

[1] History, Travel, Arts, Science, People, Places Smithsonian Magazine. History, Travel, Arts, Science, People, Places Smithsonian Magazine [online]. Copyright © 2021 Smithsonian Magazine [cit. 25.12.2021]. Dostupné z: https://www.smithsonianmag.com/smart-news/study-reveals-secrets-ancientcairo-toe180963783/. (https://www.smithsonianmag.com/smart-news/study-reveals-secrets-ancient-cairo-toe180963783/)
[2] Ancient Origins. Ancient Origins | Reconstructing the story of humanity's past
[online]. Copyright © 2013 [cit. 25.12.2021]. Dostupné z: https://www.ancientorigins.net/history-famous-people/16thcentury-prosthetic-iron-hand-story-gotzvon-berlichingen-006153 (https://www.ancient-origins.net/history-famous-people/16thcentury-prosthetic-iron-hand-story-gotz-von-berlichingen-006153)
[3] Arduino Fast(er) Sampling Rate. Wildan's Blog [online]. Copyright © 2017 [cit. 25.12.2021]. Dostupné z: https://blog.wildan.us/2017/11/03/arduino-fast-ersampling-rate/ (https://blog.wildan.us/2017/11/03/arduino-fast-er-sampling-rate/)
[4] Skeletal muscle structure and function – Musculoskeletal Genetics . Newcastle University Blogging Service [online]. Dostupné z: https://blogs.ncl.ac.uk/katarzynapirog/skeletal-muscle-structure-and-function/ (https://blogs.ncl.ac.uk/katarzynapirog/skeletal-muscle-structure-and-function/)
[5] 16th Century Prosthetic Iron Hand: The Story of Gotz von Berlichingen | Ancient
Origins. Ancient Origins | Reconstructing the story of humanity's past [online].
Copyright © 2013 [cit. 25.12.2021]. Dostupné z: https://www.ancient-origins.net/history-famous-people/16th-century-prosthetic-iron-hand-story-gotz-von-berlichingen-006153 (https://www.ancient-origins.net/history-famous-people/16th-century-prosthetic-iron-hand-story-gotz-von-berlichingen-006153)
[6] Upper Limb Prostheses | Encyclopedia.com. Encyclopedia.com | Free Online En-
cyclopedia [online]. Copyright © 2019 [cit. 25.12.2021]. Dostupné z: https://www.encyclopedia.com/medicine/encyclopedias-almanacs-transcripts-andmaps/upper-limb-prostheses (https://www.encyclopedia.com/medicine/encyclopedias-almanacs-transcripts-and-maps/upper-limb-prostheses)
[7] Timeline: Prosthetic Limbs Through the Years | UPMC HealthBeat. Expert Health
Information and Articles | UPMC HealthBeat [online]. Dostupné z:
https://share.upmc.com/2015/03/timeline-prosthetic-limbs-years/
[8] The Usefulness of Mean and Median Frequencies in Electromyography Analysis |
IntechOpen. IntechOpen - Open Science Open Minds | IntechOpen [online]. Co-
pyright © 2012 The Author [cit. 25.12.2021]. Dostupné z: https://www.intechopen.com/chapters/40123 (https://www.intechopen.com/chapters/40123)
[9] Hand and Forarm – InMoov. InMoov – open-source 3D printed life-size robot [online]. Dostupné z: http://inmoov.fr/hand-and-forarm/

30

[10] How I Designed & Built a Prosthetic Arm - YouTube. YouTube [online]. Copyright © 2021 Google LLC [cit. 25.12.2021]. Dostupné z: https://www.youtube.com/watch?v=CIqzeBxkRws&list=PLYJ6xc5oEtviBMOvdvupa6gBtBWiD_kFk&ab_channel=MahdiDesigns (https://www.youtube.com/watch?v=CIqzeBxkRws&list=PLYJ6xc5oEtviBMOvdvupa6gBtBWiD_kFk&ab_channel=MahdiDesigns)
[11] [online]. Dostupné z: https://www.science.org/doi/10.1126/scirobotics.aaw6339
[12] Advancer Technologies, LLC: MyoWare Muscle Sensor. Advancer Technologies, LLC [online]. Dostupné z: http://www.advancertechnologies.com/p/myoware.html (http://www.advancertechnologies.com/p/myoware.html)
[13] [online]. Dostupné z: https://www.ncbi.nlm.nih.gov/pmc/articles/PMC3214794/
[14] Electromyography (EMG) | Johns Hopkins Medicine. Johns Hopkins Medicine,
based in Baltimore, Maryland [online]. Copyright © [cit. 25.12.2021]. Dostupné z: https://www.hopkinsmedicine.org/health/treatment-tests-and-therapies/electromyography-emg (https://www.hopkinsmedicine.org/health/treatment-tests-and-therapies/electromyography-emg)
[15] Pololu Maestro Servo Controller User’s Guide. Pololu Robotics and Electronics [online]. Copyright © 2001 [cit. 25.12.2021]. Dostupné z: https://www.pololu.com/docs/0J40 (https://www.pololu.com/docs/0J40)
[16] Základy sportovní kineziologie | Fakulta sportovních studií. Informační systém
[online]. Dostupné z: https://is.muni.cz/do/1451/e-learning/kineziologie/elportal/pages/funkce_svalu.html (https://is.muni.cz/do/1451/e-learning/kineziologie/elportal/pages/funkce_svalu.html)
[17] Šlacha – Wikipedie. [online]. Dostupné z: https://cs.wikipedia.org/wiki/%C5%A0lacha (https://cs.wikipedia.org/wiki/%C5%A0lacha)
[18] Myofibrila – WikiSkripta. [online]. Dostupné z: https://www.wikiskripta.eu/w/Myofibrila (https://www.wikiskripta.eu/w/Myofibrila)
[19] Akční potenciál – Wikipedie. [online]. Dostupné z: https://cs.wikipedia.org/wiki/Akční_potencíal (https://cs.wikipedia.org/wiki/Akční_potencíal)
[20] Pictorial outline of the decomposition of the surface EMG signal into... | Down-
load Scientific Diagram. ResearchGate | Find and share research [online]. Copy-
right © 2008 [cit. 25.12.2021]. Dostupné z: https://www.researchgate.net/figure/Pictorial-outline-of-the-decomposition-of-the-surface-EMG-signal-into-itsconstituent_fig1_6886902 (https://www.researchgate.net/figure/Pictorial-outline-of-the-decomposition-of-the-surface-EMG-signal-into-its-constituent_fig1_6886902)
[21] Electromyography with MyoWare Muscle Sensor & Arduino. How To Electro-
nics | Engineering Projects & Tutorials [online]. Copyright © Copyright 2021, All
Rights Reserved [cit. 25.12.2021]. Dostupné z: https://how2electronics.com/electromyography-emg-with-myoware-muscle-sensor-arduino/ (https://how2electronics.com/electromyography-emg-with-myoware-muscle-sensor-arduino/)

SEZNAM PŘÍLOH

Obrázek 1.1 https://www.smithsonianmag.com/smart-news/study-reveals-secrets-ancient-

cairo-toe-180963783/

obrázek 1.2 https://wellcomecollection.org/works/kyjgqfuh

obrázek 1.3 https://commons.wikimedia.org/wiki/File:Berlichingen_Eiserne_Hand_1.jpg

obrázek 1.5 https://www.armdynamics.com/our-care/prosthetic-options

obrázek | 1.6 | https://www.ottobock-export.com/en/prosthetics/upper-limb/solution-over-

view/arm-prostheses-body-powered/

obrázek 1.7 https://www.ottobockus.com/prosthetics/upper-limb-prosthetics/solution-over-

view/myoelectric-prosthetics/

obrázek 2.1 https://www.vut.cz/www_base/zav_prace_soubor_verejne.php?file_id=192502

obrázek 2.2 https://www.vut.cz/www_base/zav_prace_soubor_verejne.php?file_id=192502

obrázek 2.3 https://www.researchgate.net/figure/Pictorial-outline-of-the-decomposition-of-

the-surface-EMG-signal-into-its-constituent_fig1_6886902

obrázek 2.4 https://how2electronics.com/electromyography-emg-with-myoware-muscle-

sensor-arduino/

obrázek 3.1 http://www.advancertechnologies.com/p/myoware.html

obrázek | 3.2 | https://www.amazon.com/Humanoid-Fingers-Metal-Manipulator-Ser-

vos/dp/B076Q4DYPN

obrázek 3.3 http://inmoov.fr/gallery-v2/
