Vistoun/EMG-arm/stl/hand and forearm/Auriculaire3.stl

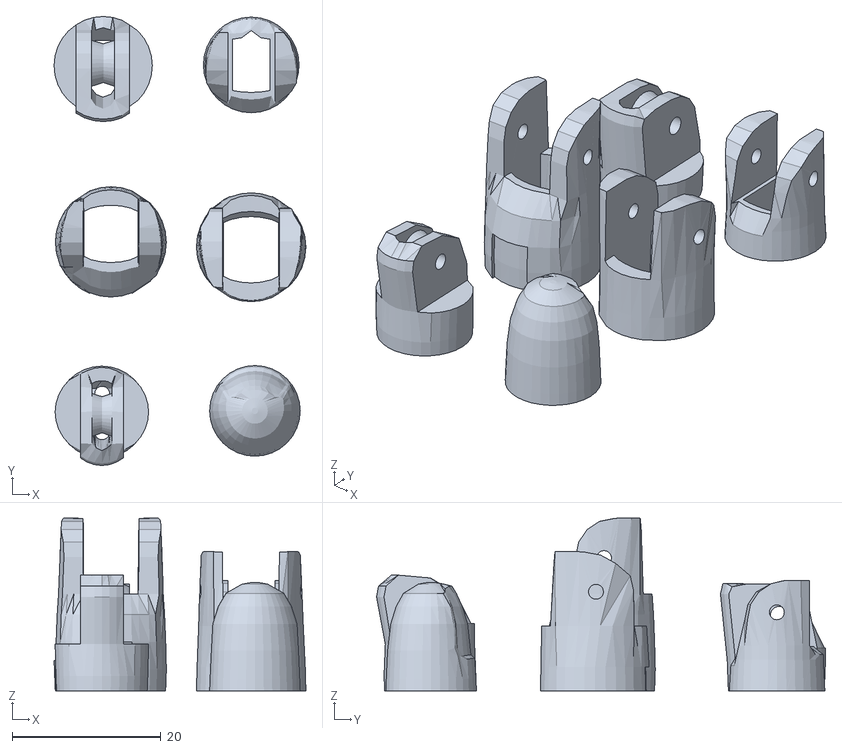
[picture p32: CAD file, 2021-11-28]
stl/hand and forearm/Auriculaire3.stl
33.8 x 60.3 x 23.2
