Vistoun/EMG-arm/stl/stojan/Spodni víko.stl

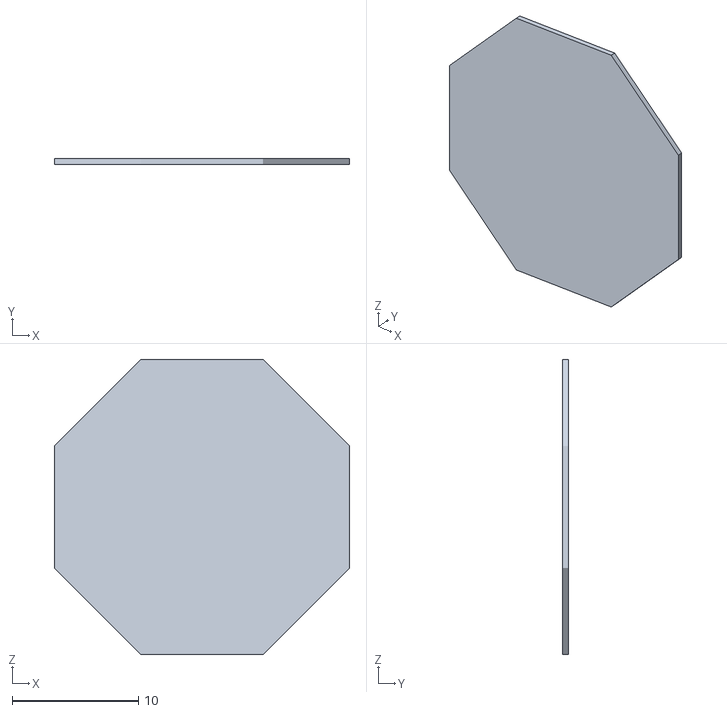
[picture p33: CAD file, 2021-11-28]
stl/stojan/Spodni víko.stl
23.4 x 0.45 x 23.4
