Vistoun/EMG-arm/stl/wrist + servo things/TensionerRightV1.stl

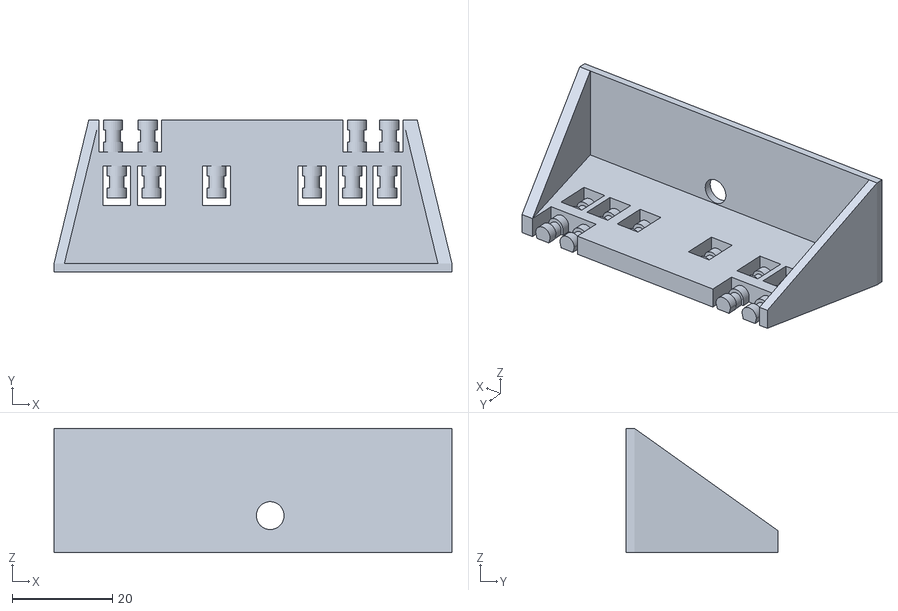
[picture p34: CAD file, 2021-11-28]
stl/wrist + servo things/TensionerRightV1.stl
79.3 x 30.3 x 24.7
