Vistoun/EMG-arm/stl/wrist + servo things/wrist/CableHolderWristV5.stl

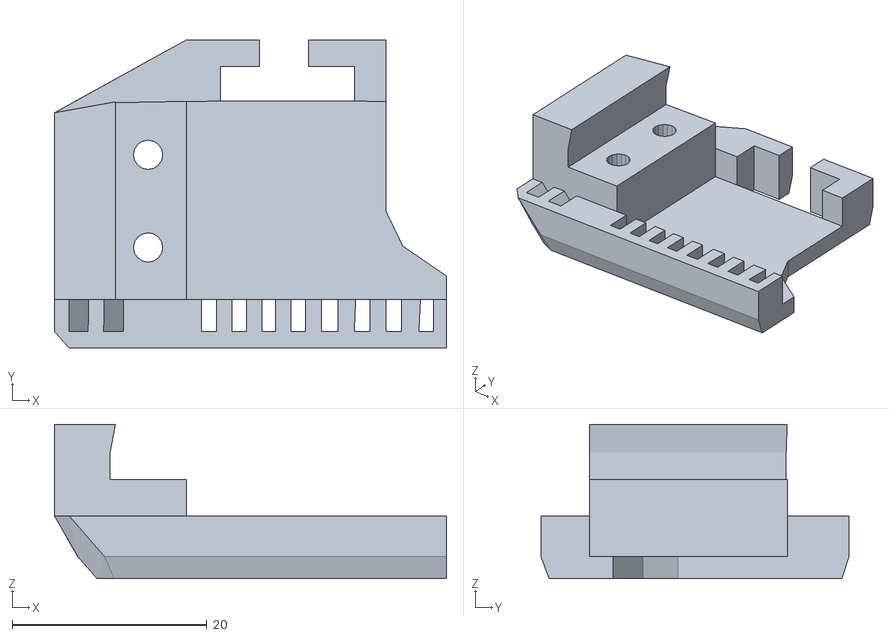
[picture p35: CAD file, 2021-11-28]
stl/wrist + servo things/wrist/CableHolderWristV5.stl
40.2 x 31.6 x 15.8
