Vistoun/EMG-arm/stl/hand and forearm/WristlargeV4.stl

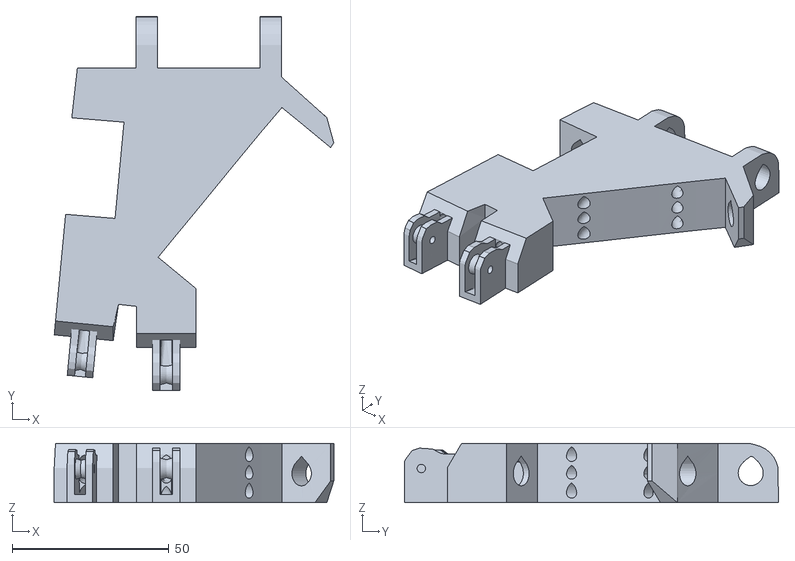
[picture p36: CAD file, 2021-11-28]
stl/hand and forearm/WristlargeV4.stl
89.2 x 119.4 x 18.9
