Vistoun/EMG-arm/stl/stojan/Víko.stl

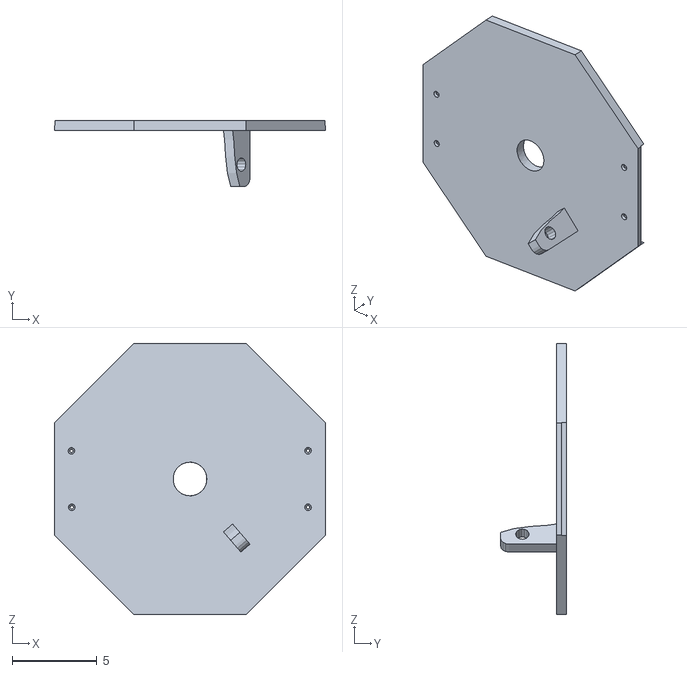
[picture p37: CAD file, 2021-11-28]
stl/stojan/Víko.stl
16.0 x 3.90 x 16.0
