Vistoun/EMG-arm/stl/wrist + servo things/RobCableBackV3.stl

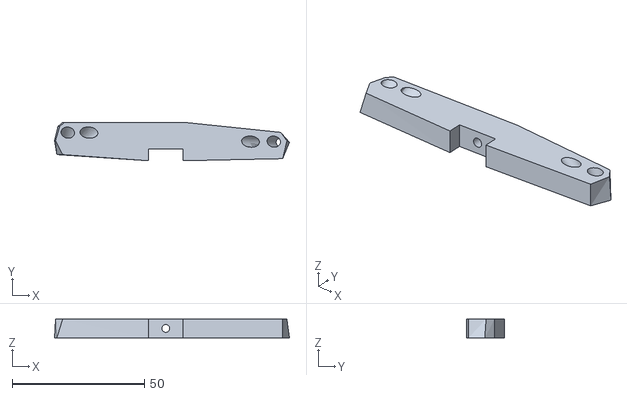
[picture p38: CAD file, 2021-11-28]
stl/wrist + servo things/RobCableBackV3.stl
88.7 x 14.5 x 7.17
