Vistoun/EMG-arm/stl/wrist + servo things/wrist/RotaWrist3V3.stl

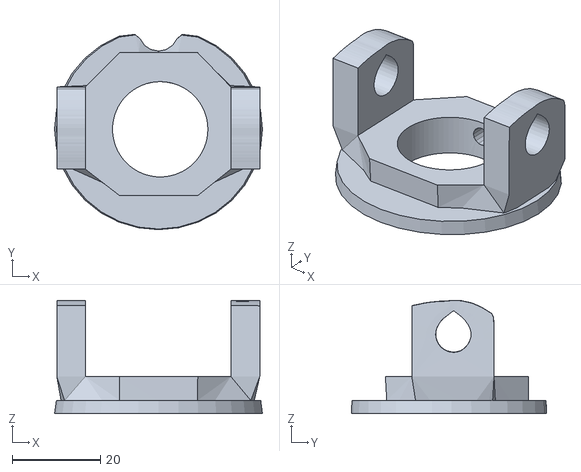
[picture p39: CAD file, 2021-11-28]
stl/wrist + servo things/wrist/RotaWrist3V3.stl
47.2 x 44.3 x 25.7
