Vistoun/EMG-arm/stl/hand and forearm/robpart2V4.stl

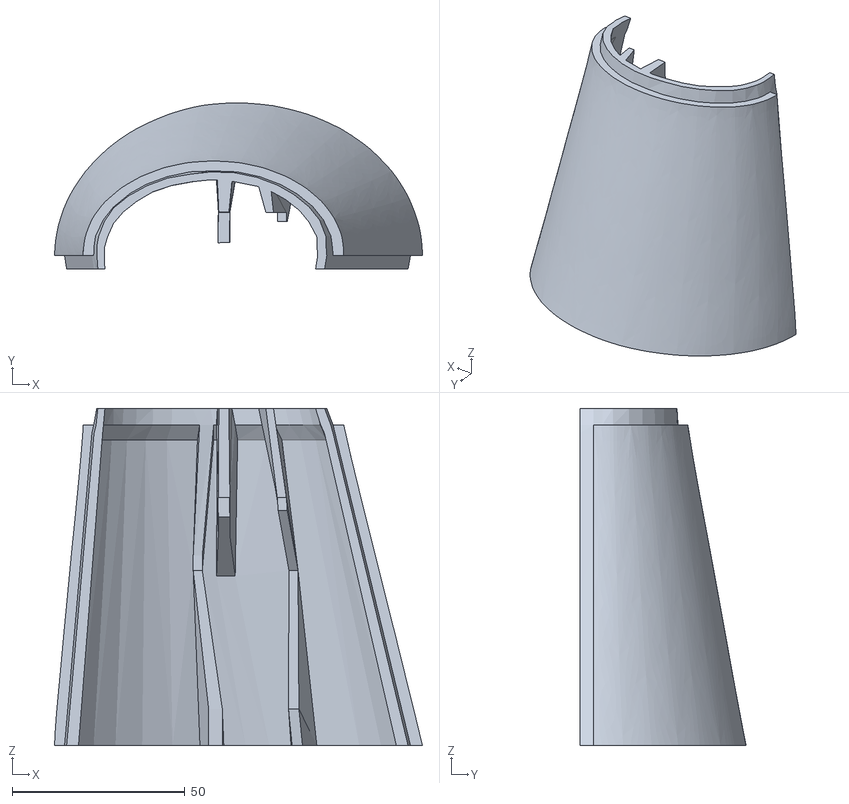
[picture p40: CAD file, 2021-11-28]
stl/hand and forearm/robpart2V4.stl
106.4 x 48.1 x 97.5
