Vistoun/EMG-arm/stl/stojan/Stojan.stl

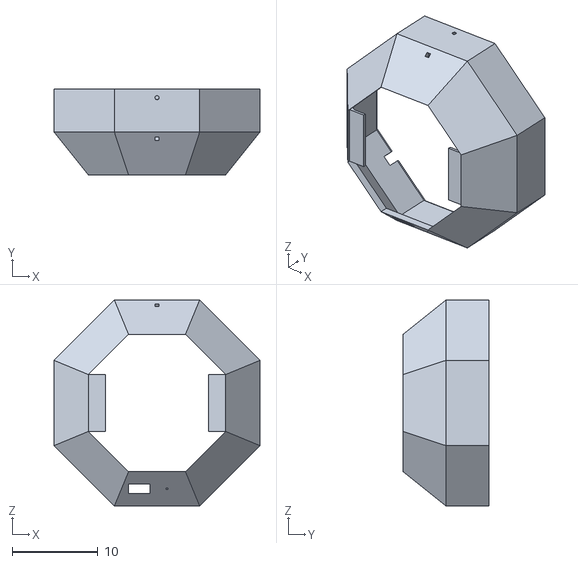
[picture p41: CAD file, 2021-11-28]
stl/stojan/Stojan.stl
24.0 x 10.0 x 24.0
