Vistoun/EMG-arm/stl/wrist + servo things/RobRingV3.stl

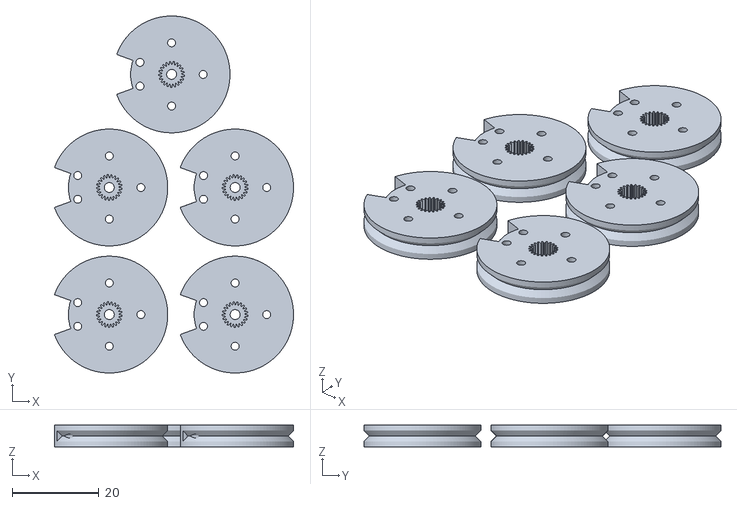
[picture p42: CAD file, 2021-11-28]
stl/wrist + servo things/RobRingV3.stl
55.3 x 82.5 x 5.00
