Vistoun/EMG-arm/stl/wrist + servo things/wrist/WristGearsV5.stl

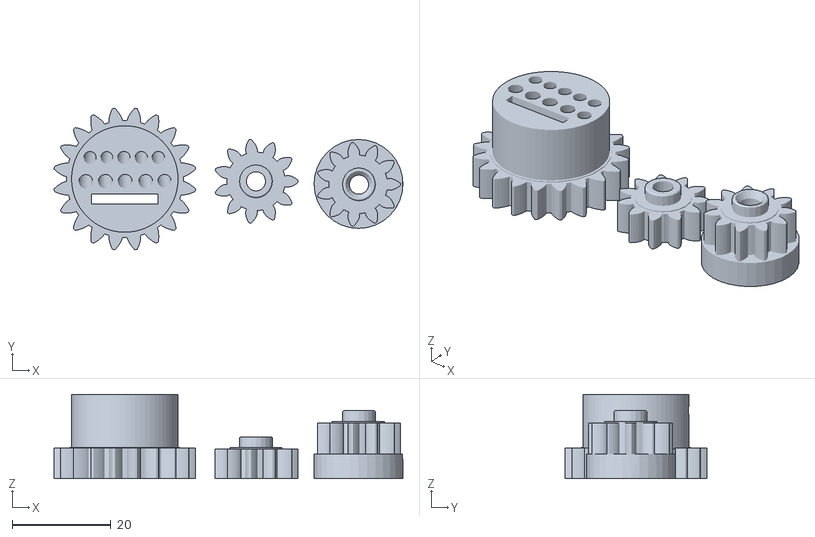
[picture p43: CAD file, 2021-11-28]
stl/wrist + servo things/wrist/WristGearsV5.stl
70.7 x 28.7 x 17.1
