Vistoun/EMG-arm/stl/hand and forearm/robcap3V2.stl

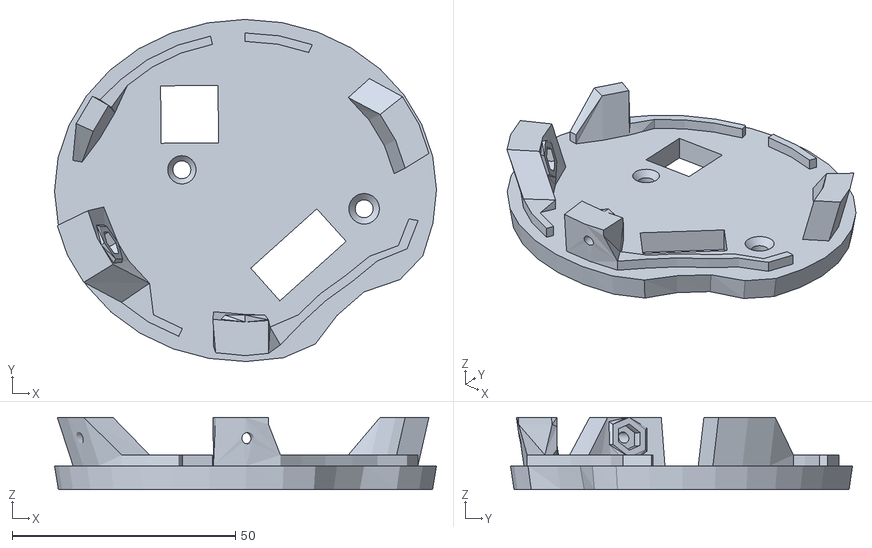
[picture p44: CAD file, 2021-11-28]
stl/hand and forearm/robcap3V2.stl
85.5 x 76.5 x 16.2
