Vistoun/EMG-arm/stl/wrist + servo things/RobCableFrontV3.stl

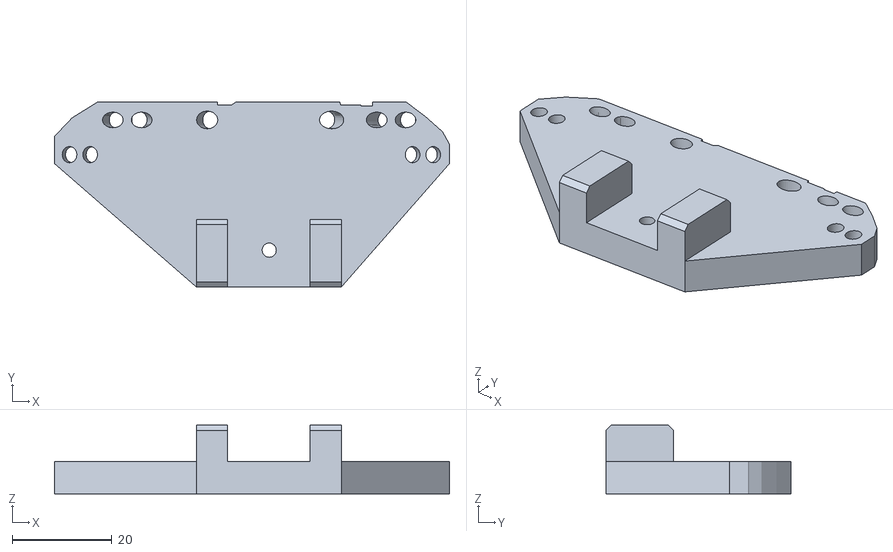
[picture p45: CAD file, 2021-11-28]
stl/wrist + servo things/RobCableFrontV3.stl
79.3 x 37.1 x 13.8
