Vistoun/EMG-arm/stl/wrist + servo things/wrist/RotaWrist2V3.stl

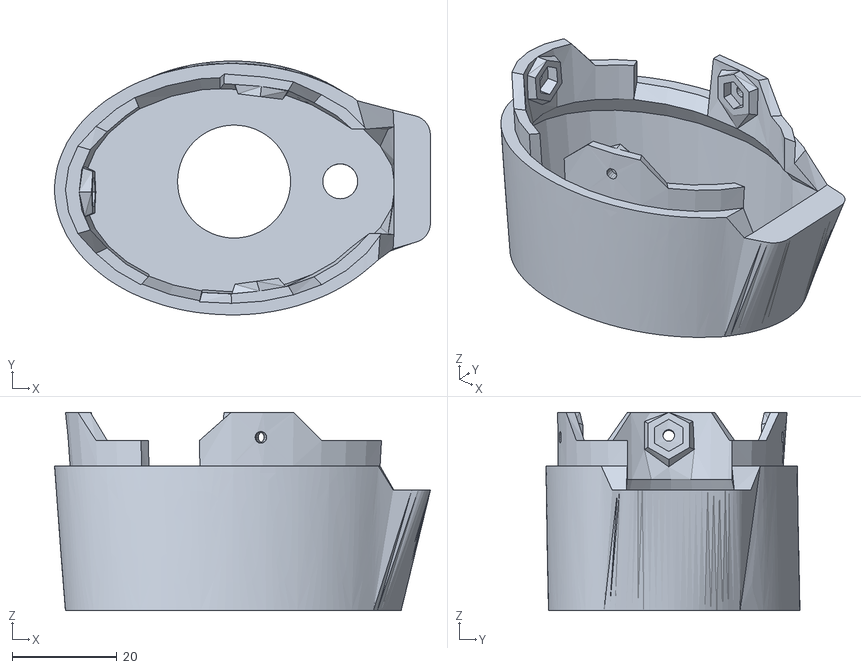
[picture p46: CAD file, 2021-11-28]
stl/wrist + servo things/wrist/RotaWrist2V3.stl
71.9 x 48.6 x 38.0
