Vistoun/EMG-arm/stl/hand and forearm/robpart3V4.stl

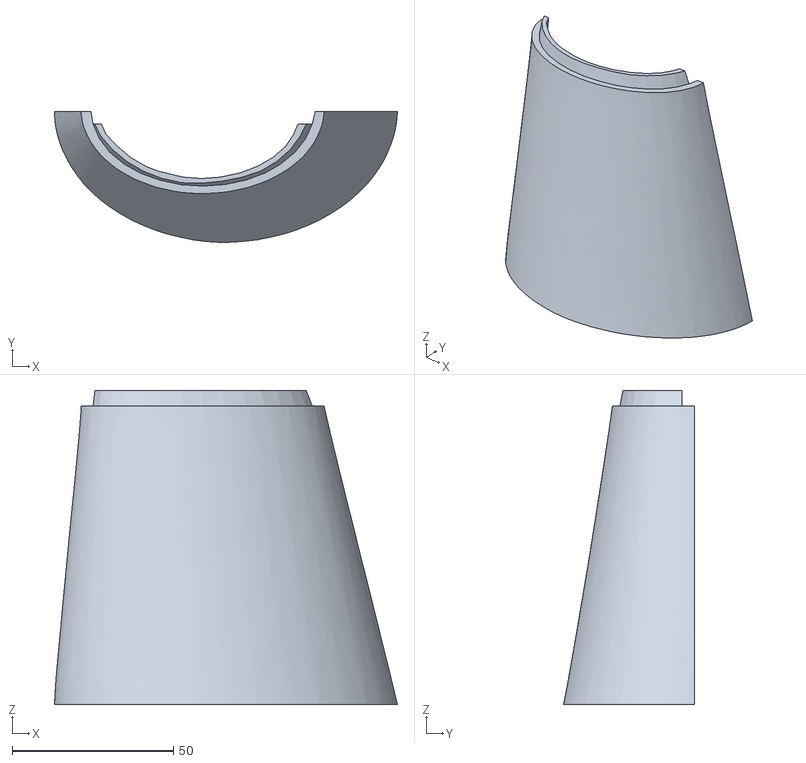
[picture p47: CAD file, 2021-11-28]
stl/hand and forearm/robpart3V4.stl
106.4 x 40.6 x 97.5
