Vistoun/EMG-arm/stl/wrist + servo things/servo-pulleyX5.stl

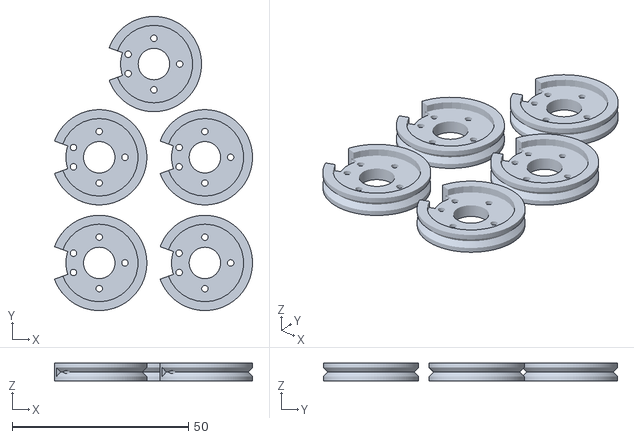
[picture p48: CAD file, 2021-11-28]
stl/wrist + servo things/servo-pulleyX5.stl
56.1 x 83.4 x 5.00
