Vistoun/EMG-arm/stl/wrist + servo things/wrist/RotaWrist1V4.stl

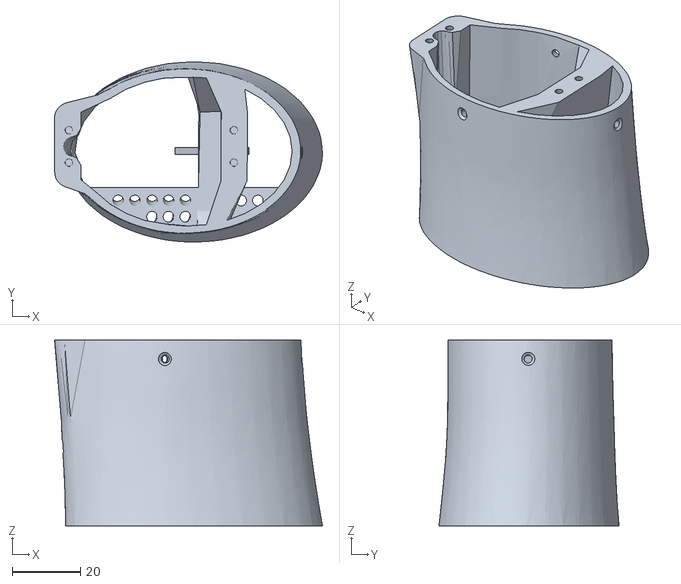
[picture p49: CAD file, 2021-11-28]
stl/wrist + servo things/wrist/RotaWrist1V4.stl
78.6 x 52.8 x 54.5
