Vistoun/EMG-arm/stl/hand and forearm/Majeure3.stl

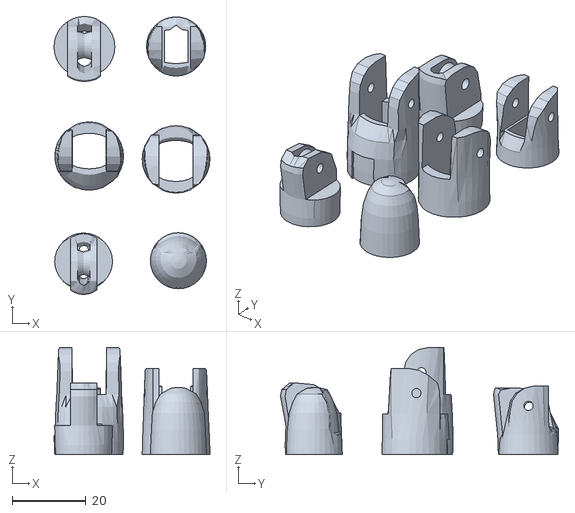
[picture p50: CAD file, 2021-11-28]
stl/hand and forearm/Majeure3.stl
42.2 x 75.2 x 29.0
