Vistoun/EMG-arm/stl/wrist + servo things/RobServoBedV6.stl

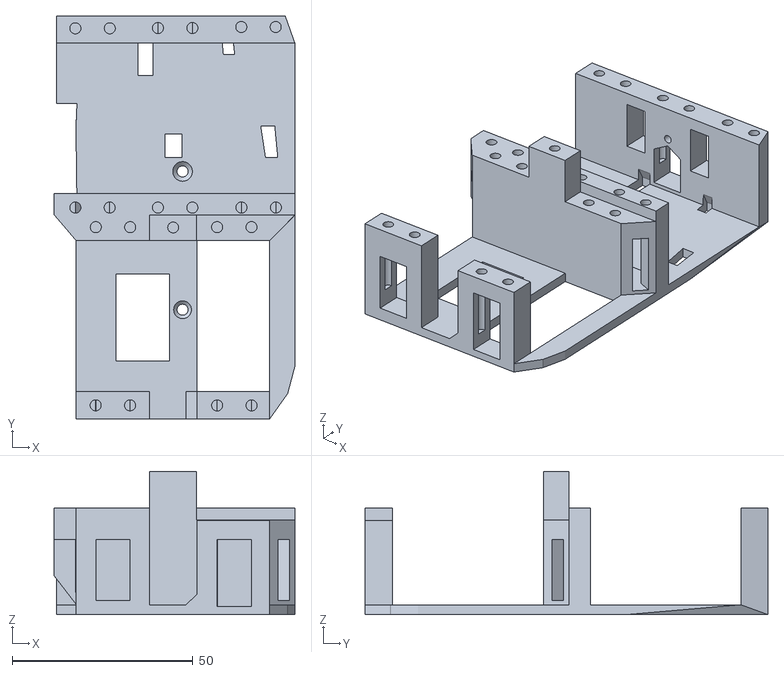
[picture p51: CAD file, 2021-11-28]
stl/wrist + servo things/RobServoBedV6.stl
66.7 x 111.6 x 39.7
