Vistoun/EMG-arm/stl/hand and forearm/topsurface6.stl

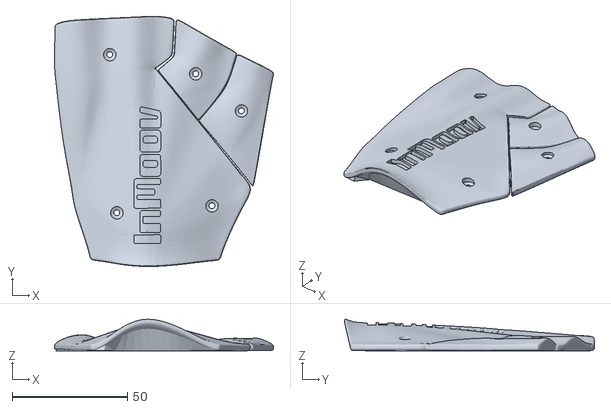
[picture p52: CAD file, 2021-11-28]
stl/hand and forearm/topsurface6.stl
94.8 x 108.3 x 13.7
