Vistoun/EMG-arm/stl/hand and forearm/robpart4V4.stl

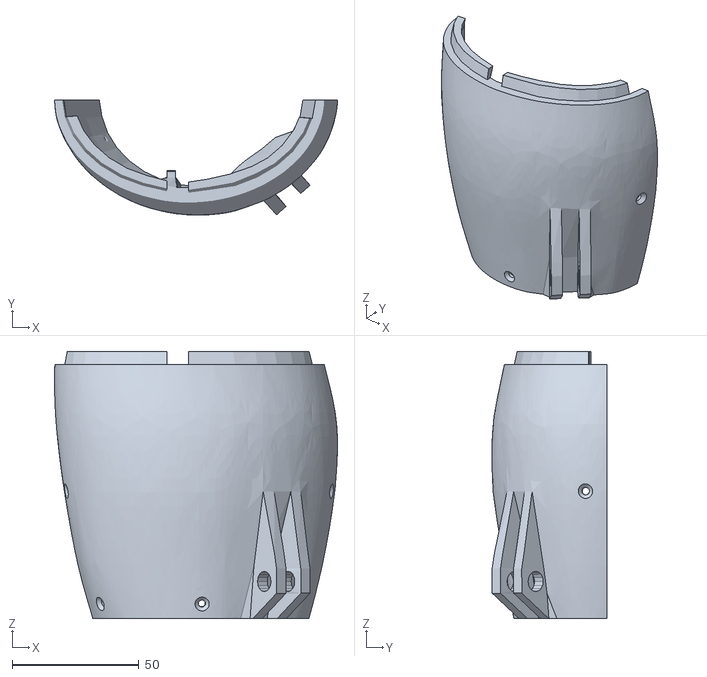
[picture p53: CAD file, 2021-11-28]
stl/hand and forearm/robpart4V4.stl
111.8 x 45.5 x 105.6
