Vistoun/EMG-arm/stl/hand and forearm/Calibrator.stl

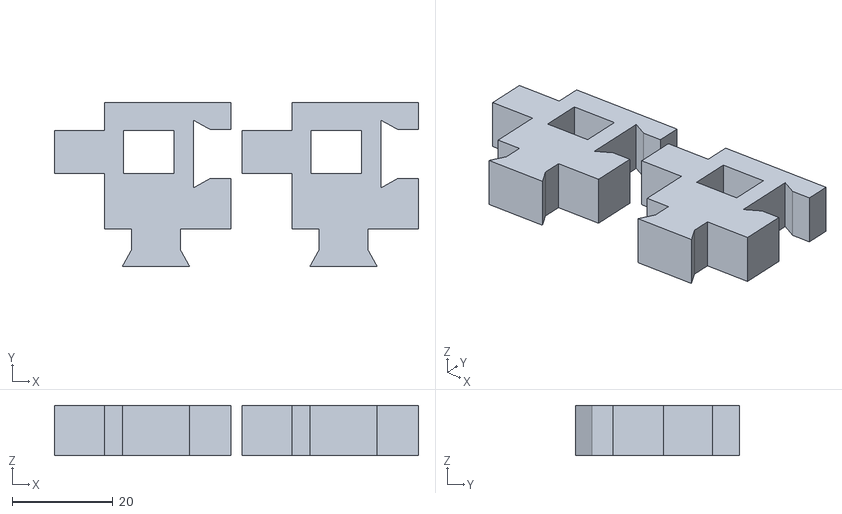
[picture p54: CAD file, 2021-11-28]
stl/hand and forearm/Calibrator.stl
72.2 x 32.5 x 9.99
