Vistoun/EMG-arm/stl/hand and forearm/ringfinger3.stl

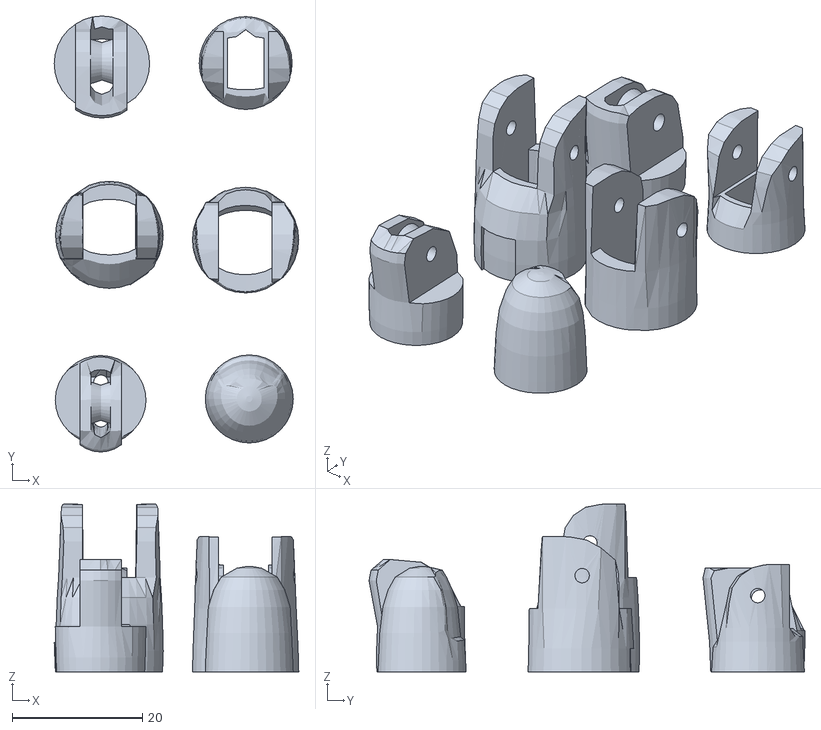
[picture p55: CAD file, 2021-11-28]
stl/hand and forearm/ringfinger3.stl
37.6 x 67.0 x 25.8
