Vistoun/EMG-arm/stl/hand and forearm/WristsmallV4.stl

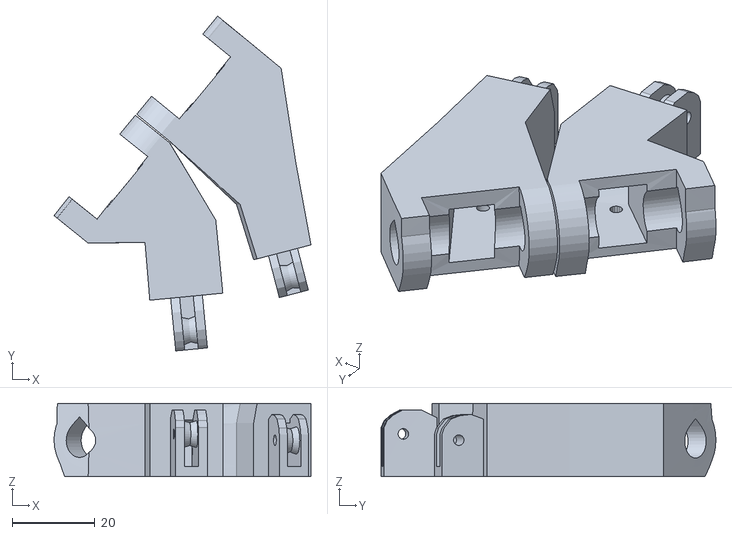
[picture p56: CAD file, 2021-11-28]
stl/hand and forearm/WristsmallV4.stl
62.0 x 80.8 x 17.7
