Vistoun/EMG-arm/stl/hand and forearm/Index3.stl

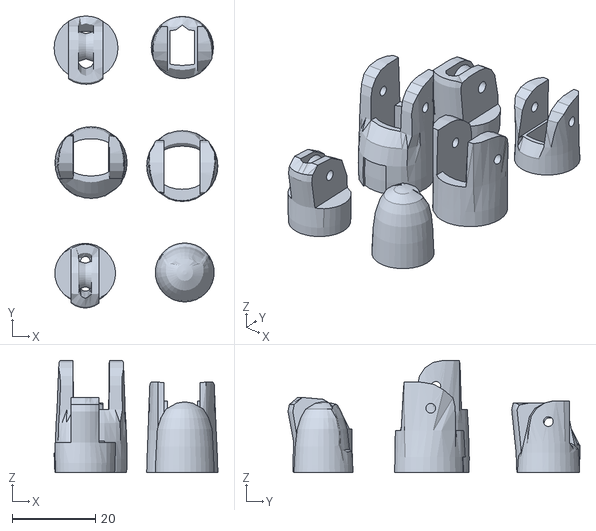
[picture p57: CAD file, 2021-11-28]
stl/hand and forearm/Index3.stl
39.4 x 70.2 x 27.0
