Vistoun/EMG-arm/stl/hand and forearm/thumb5.stl

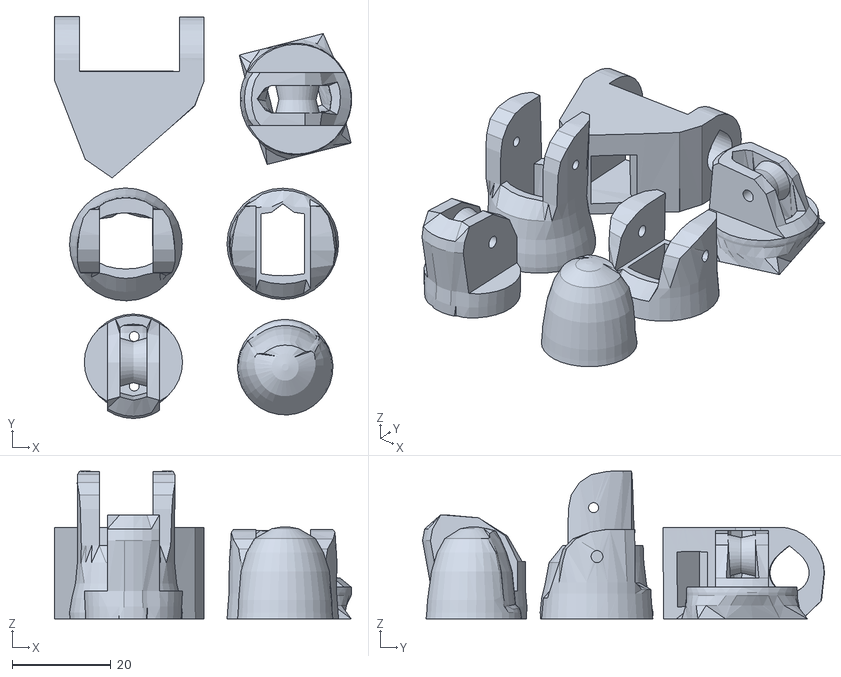
[picture p58: CAD file, 2021-11-28]
stl/hand and forearm/thumb5.stl
60.1 x 81.2 x 29.8
