Vistoun/EMG-arm/stl/hand and forearm/robpart5V4.stl

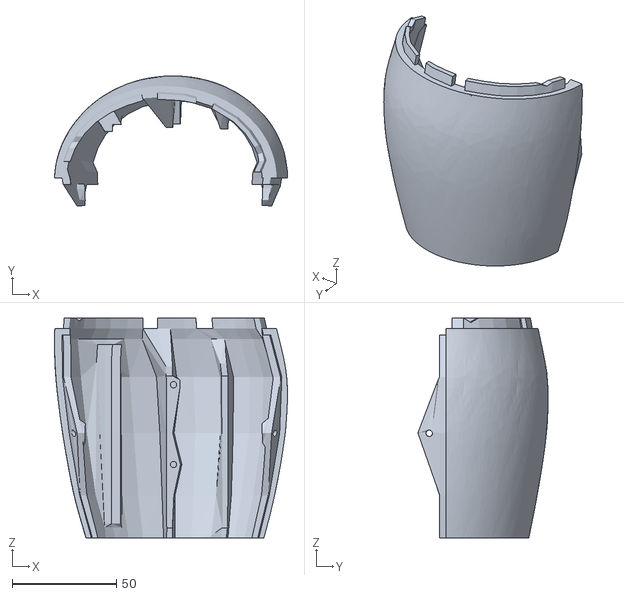
[picture p59: CAD file, 2021-11-28]
stl/hand and forearm/robpart5V4.stl
111.8 x 62.5 x 105.6
