Vistoun/EMG-arm/stl/hand and forearm/coverfinger1.stl

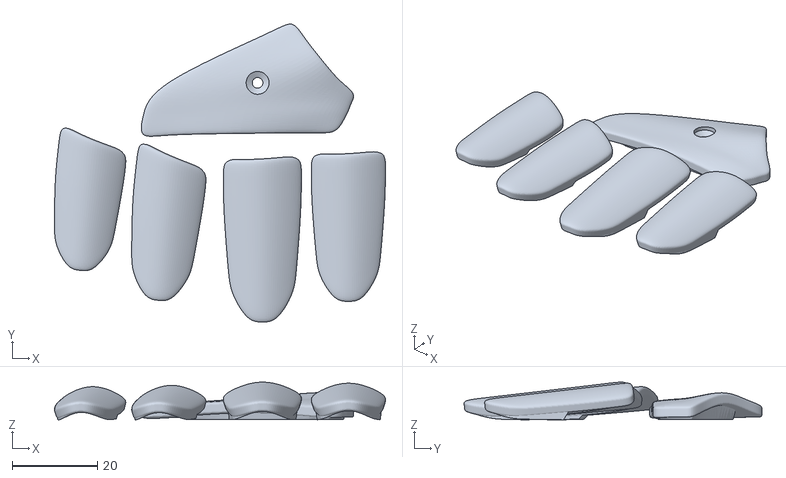
[picture p60: CAD file, 2021-11-28]
stl/hand and forearm/coverfinger1.stl
77.7 x 69.9 x 8.87
