Vistoun/EMG-arm/(list of files, cad)

Other CAD files:
stl/hand and forearm/Bolt_entretoise7.stl
