Vistoun/EMG-arm/src/Arm.hpp

#include <Arduino.h>

class Arm{
public:
    Arm();
    Arm(uint8_t, uint8_t, uint8_t, uint8_t, uint8_t, uint8_t, uint16_t, uint16_t, uint16_t, uint16_t);
    Arm(const Arm&);
    virtual ~Arm();

    // Get a finger channel
    uint8_t getWrist()const;
    uint8_t getThumb()const;
    uint8_t getIndex()const;
    uint8_t getMiddle()const;
    uint8_t getRing()const;
    uint8_t getPinky()const;
    uint16_t getSpeed()const;
    uint16_t getAcceleration()const;

    // Get a current finger position 
    uint16_t getWristPos()const;
    uint16_t getThumbPos()const;
    uint16_t getIndexPos()const;
    uint16_t getMiddlePos()const;
    uint16_t getRingPos()const;
    uint16_t getPinkyPos()const;
    uint16_t getSpeedPos()const;

    // Set a finger channel 
    void setWrist(uint8_t);
    void setThumb(uint8_t);
    void setIndex(uint8_t);
    void setMiddle(uint8_t);
    void setRing(uint8_t);
    void setPinky(uint8_t);
    void setSpeed(uint16_t);
    void setAcceleration(uint16_t);
    
    // Fully open a finger 
    void openThumb()const;
    void openIndex()const;
    void openMiddle()const;
    void openRing()const;
    void openPinky()const;

    // Fully close finger
    void closeThumb()const;
    void closeIndex()const;
    void closeMiddle()const;
    void closeRing()const;
    void closePinky()const;

    // Open and Close all the fingers
    void openFist()const;
    void closeFist()const;    

    // Move custom finger to custom posistion
    void moveFinger(uint8_t, uint16_t);

    //Gestures
    void thumbsUp()const;
    void peace()const;
    void ok()const;
    void countdown()const;
    void rock()const;
    void callMe()const;

private:
uint8_t wrist, thumb, index, middle, ring, pinky; 
uint16_t speed, acceleration, open, close;
};
