Vistoun/EMG-arm/(commit log)

2021-10-16 added arm class
2021-10-17 added open/close finger functions
2021-10-31 encoder servo control
2021-11-01 encoder wtf pls work
2021-11-02 implemented encoder libary
2021-11-04 fixing maestro getting pos
    [Arm.cpp, main.cpp]
2021-11-08 fixed cursor running outside of the screen
    [main.cpp]
2021-11-15 fixed cursors aligment with icons
    [main.cpp]
2021-11-23 emg sensor reading
2021-11-28 stl and icons files
    [Auriculaire3.stl, Bolt_entretoise7.stl, CableHolderWristV5.stl, Calibrator.stl, Index3.stl, Majeure3.stl, RobCableBackV3.stl, RobCableFrontV3.stl]
2021-12-01 emg screen, min&max sensor values
2021-12-05 changed encoder function
2021-12-13 battery capacity checker
